clectric-diy/Spark-AE/README.md

Please use these available resources:
- [Canonical Documentation](https://clectric.diy/Spark-AE/)
- [Community Wiki](https://github.com/clectric-diy/Spark-AE/wiki)
- [clectric.diy Discussions](https://github.com/orgs/clectric-diy/discussions)
