clectric-diy/Spark-AE/KiCad/Spark-AE-Arcs/README.md

Arcs are expansion submodules that connect to the primary Spark module via SPI or I2C.
