clectric-diy/Spark-AE/docs/images/Spark-AE-1st-Sketch.png

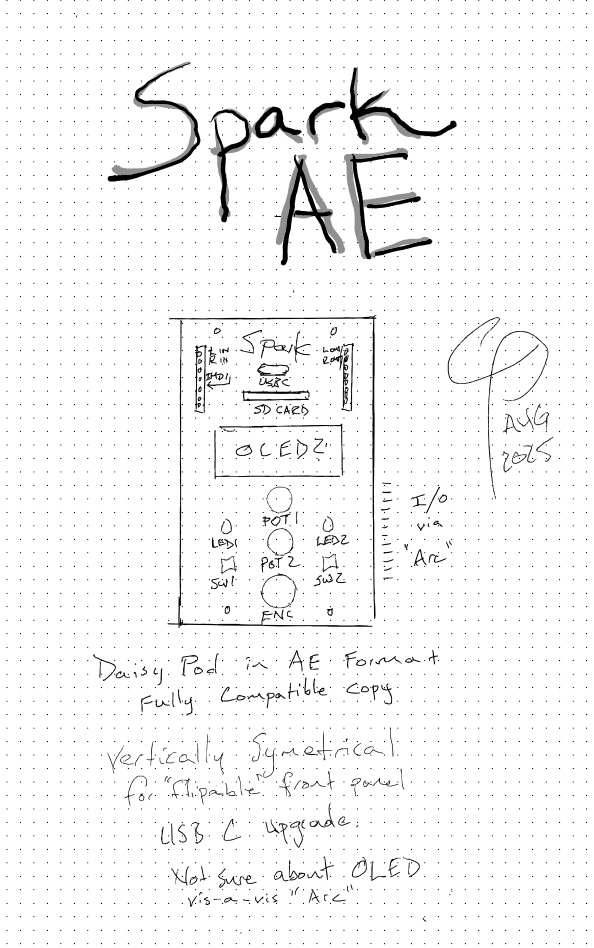
docs/images/Spark-AE-1st-Sketch.png
