clectric-diy/Spark-AE/docs/images/Spark-AE-PCB_Mk_0.0-DEV-Bottom.png

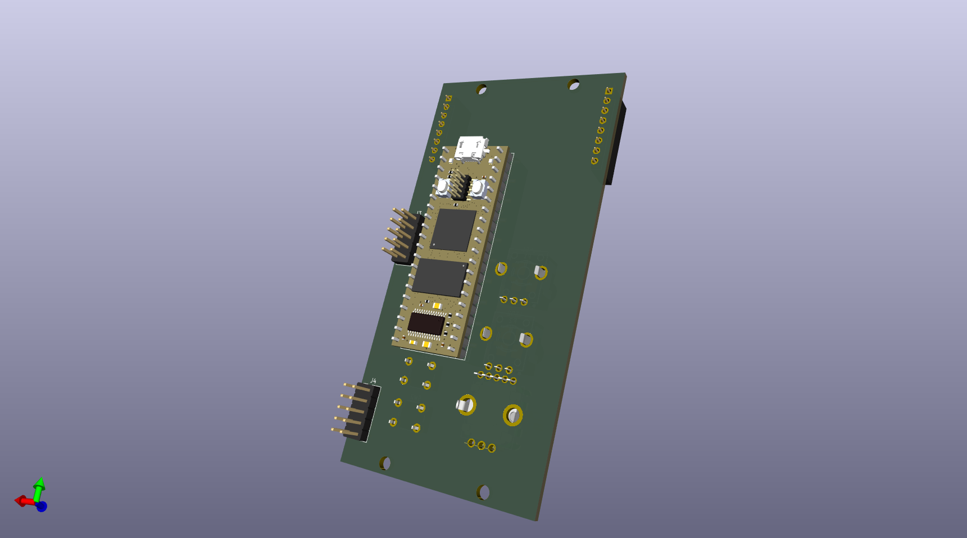
docs/images/Spark-AE-PCB_Mk_0.0-DEV-Bottom.png
