clectric-diy/Spark-AE/KiCad/Spark-AE-Panels/Spark-AE-Panel-Original/Lightburn/Spark-AE-Panel-Original-Edge_Cuts.dxf

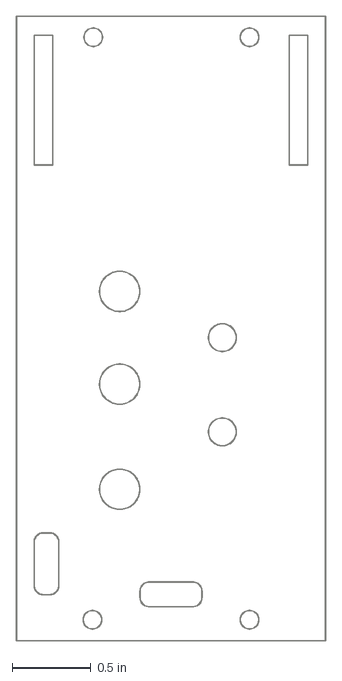
[picture p4: CAD file, 2026-04-26]
KiCad/Spark-AE-Panels/Spark-AE-Panel-Original/Lightburn/Spark-AE-Panel-Original-Edge_Cuts.dxf
1.97 x 3.98 in
