clectric-diy/Spark-AE/(list of files, cad)

Other CAD files:
KiCad/Spark-AE-Panels/Spark-AE-Panel-Original/Lightburn/Spark-AE-Panel-Original-F_Silkscreen.dxf
