clectric-diy/Spark-AE/docs/schematics/Spark-AE-Schematic-Mk0.1.pdf

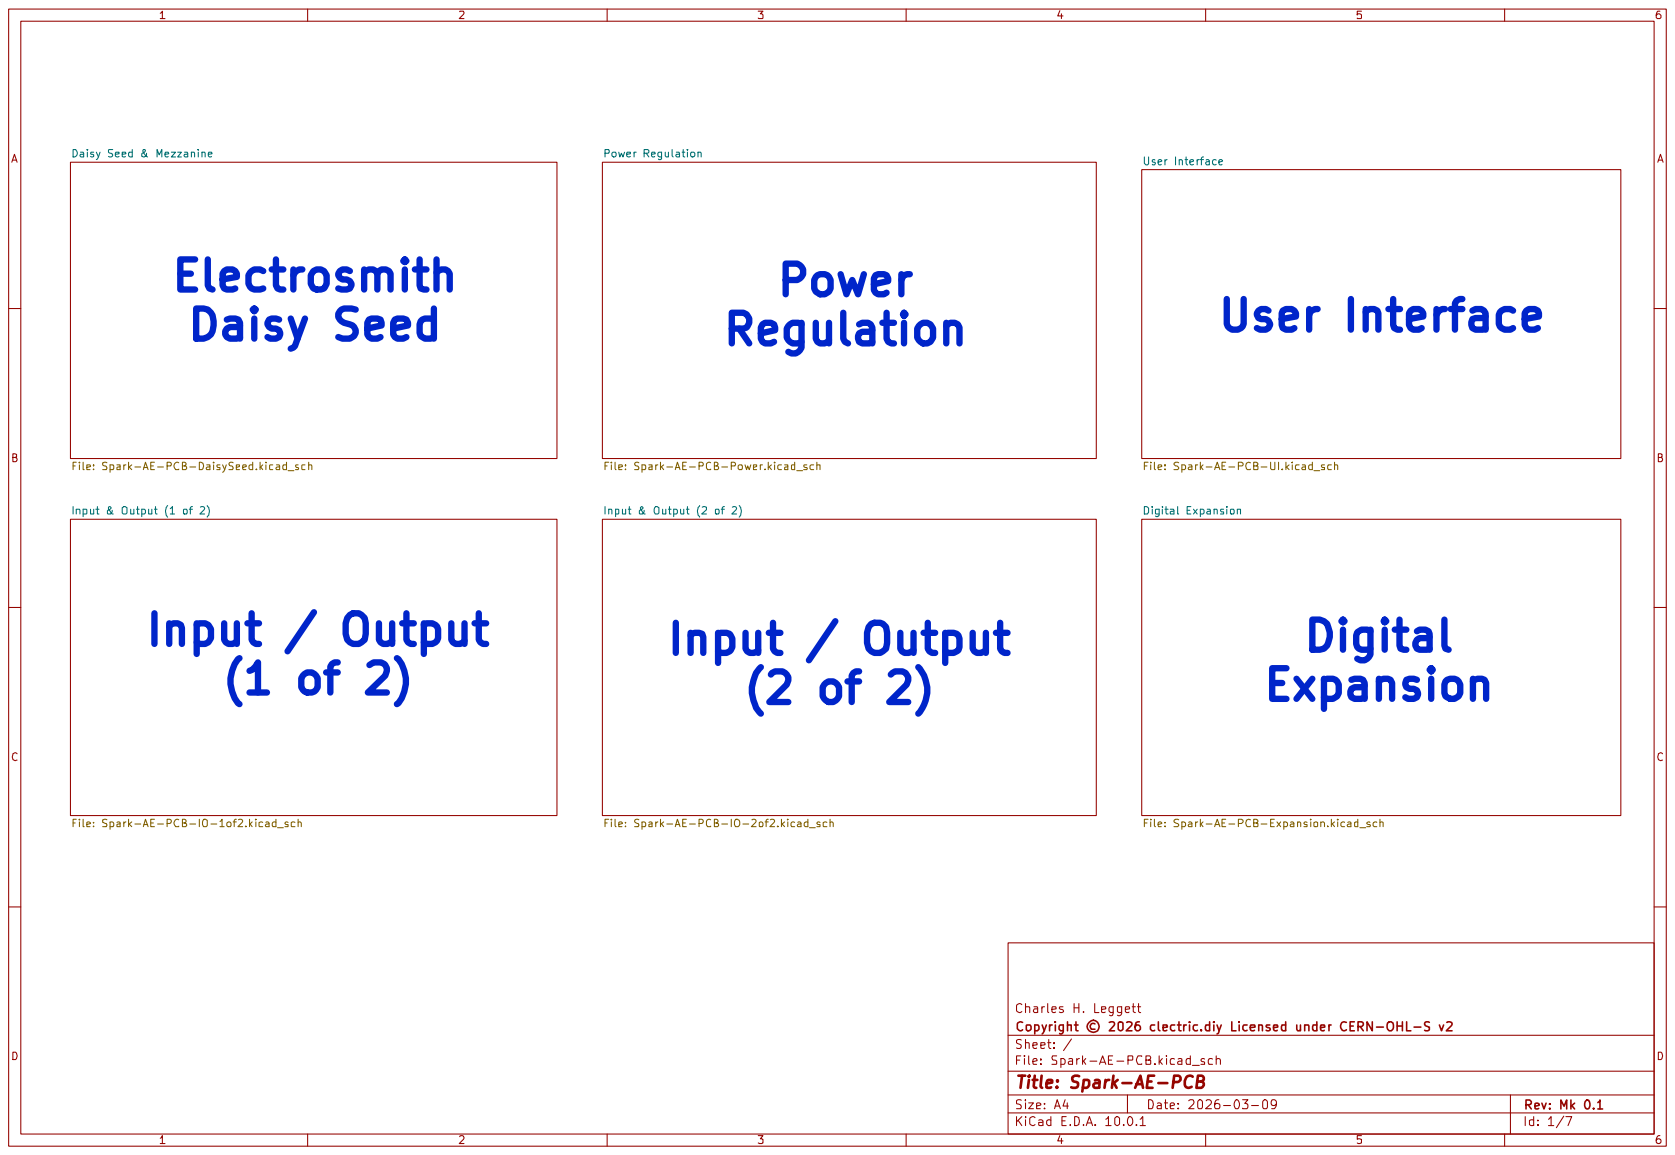
[picture p5: page 1]

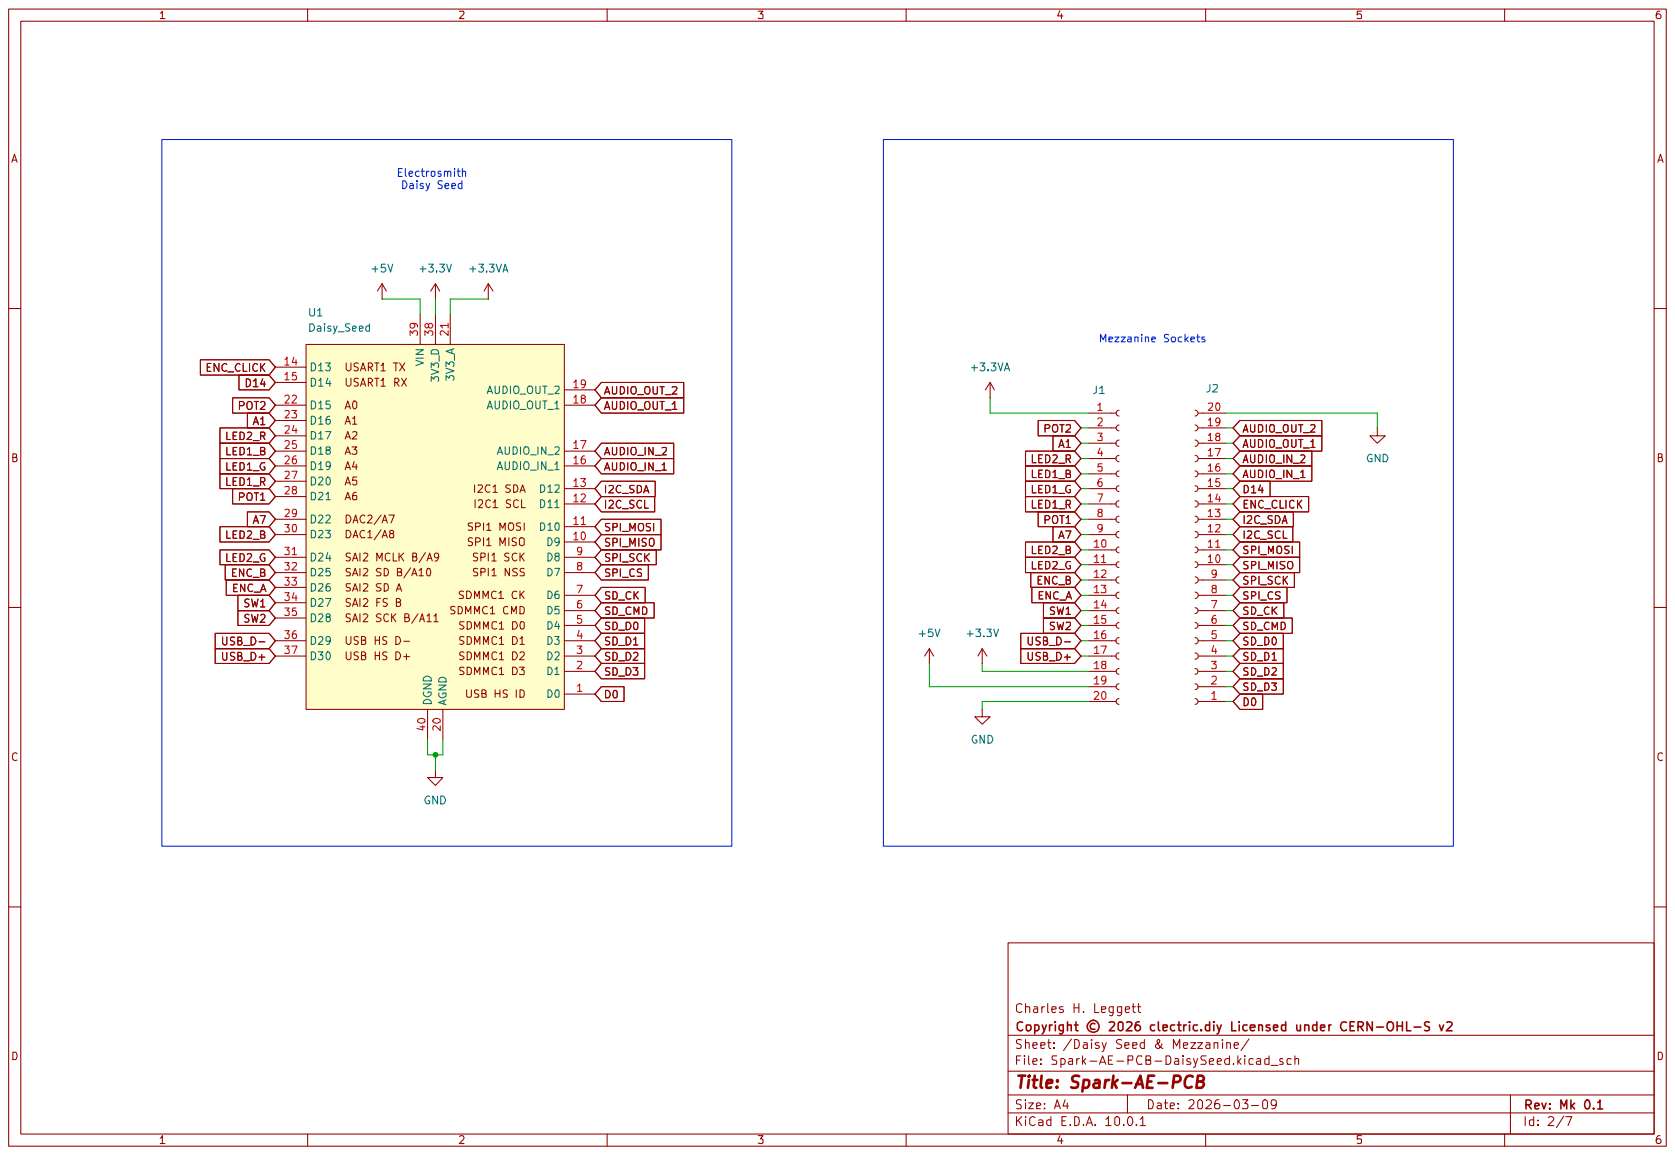
[picture p6: page 2]

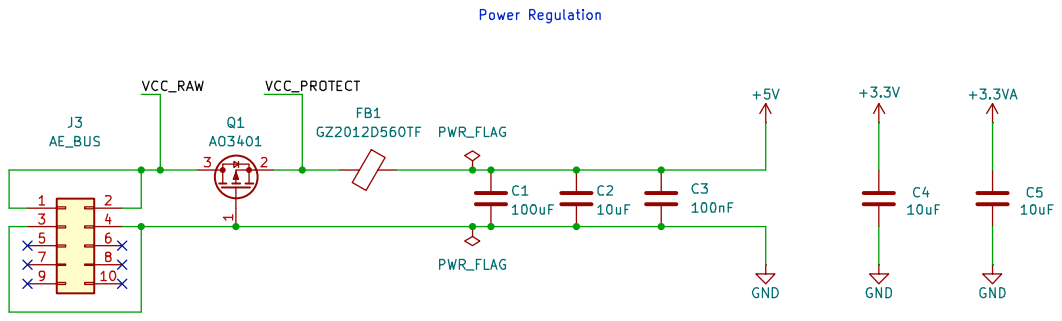
[picture p7: page 3]

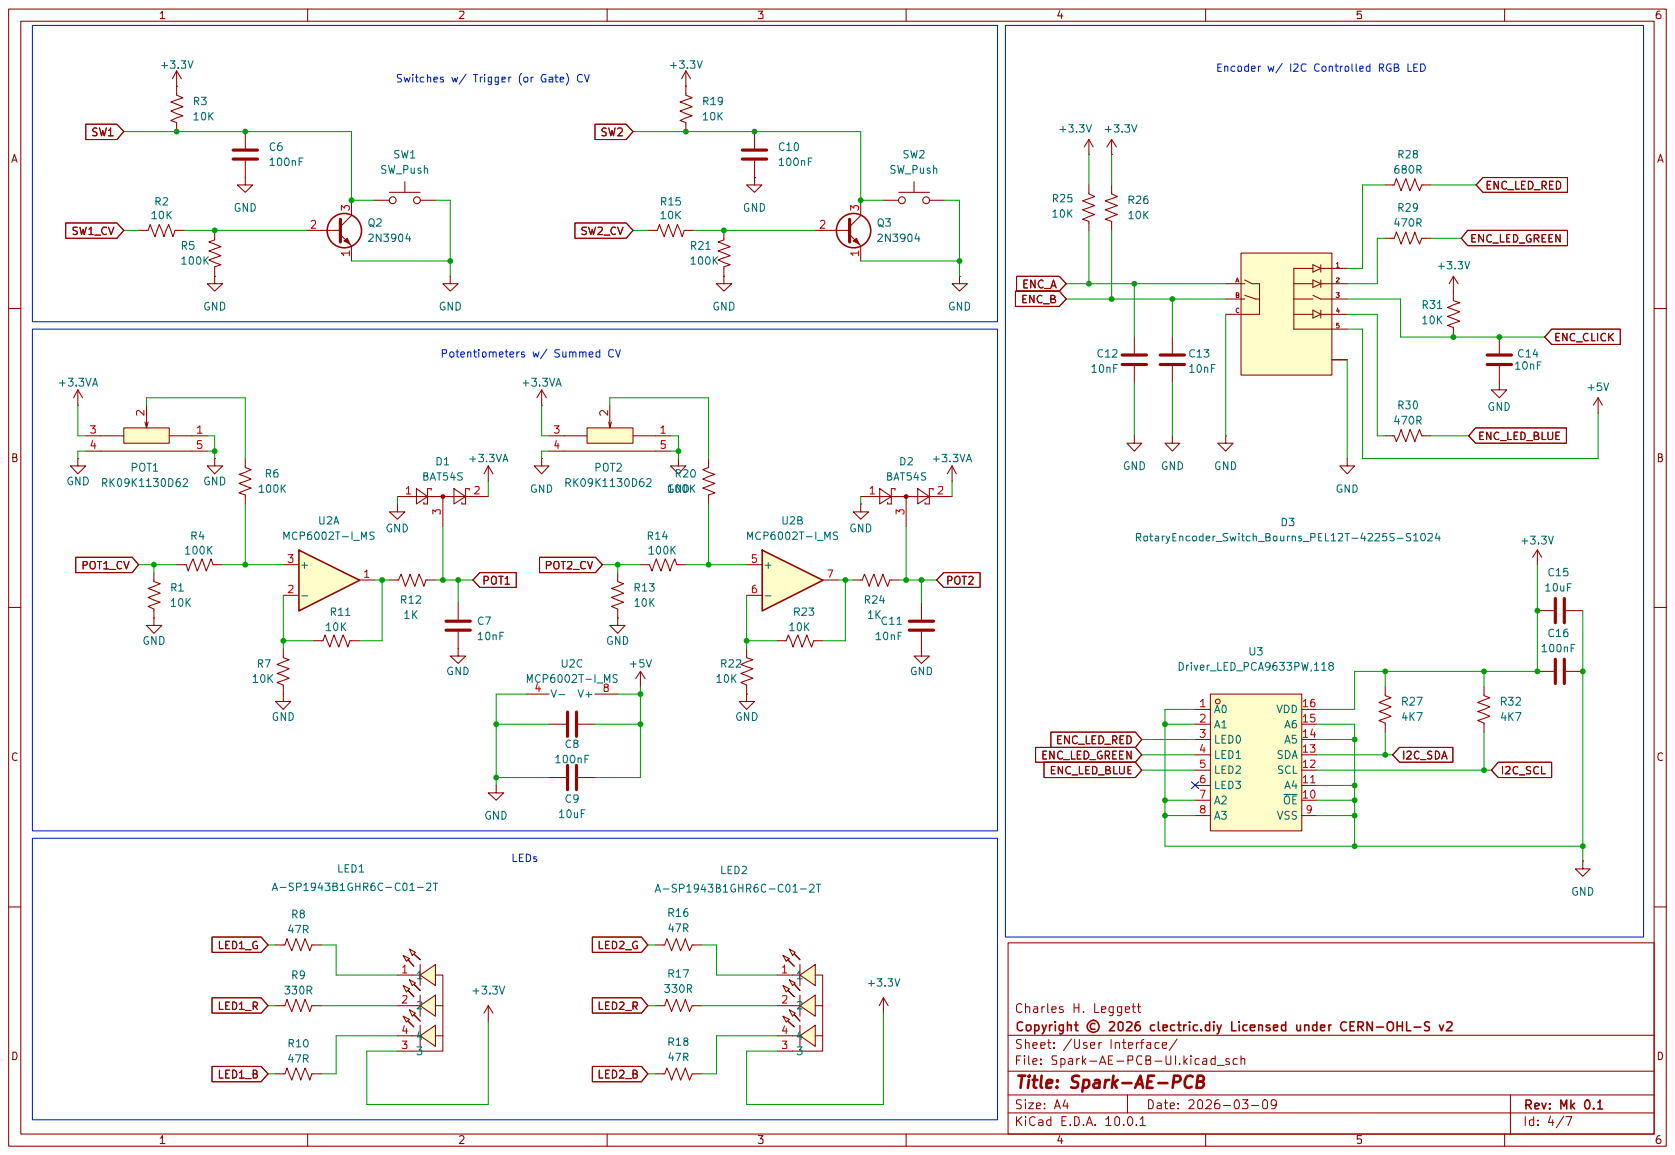
[picture p8: page 4]

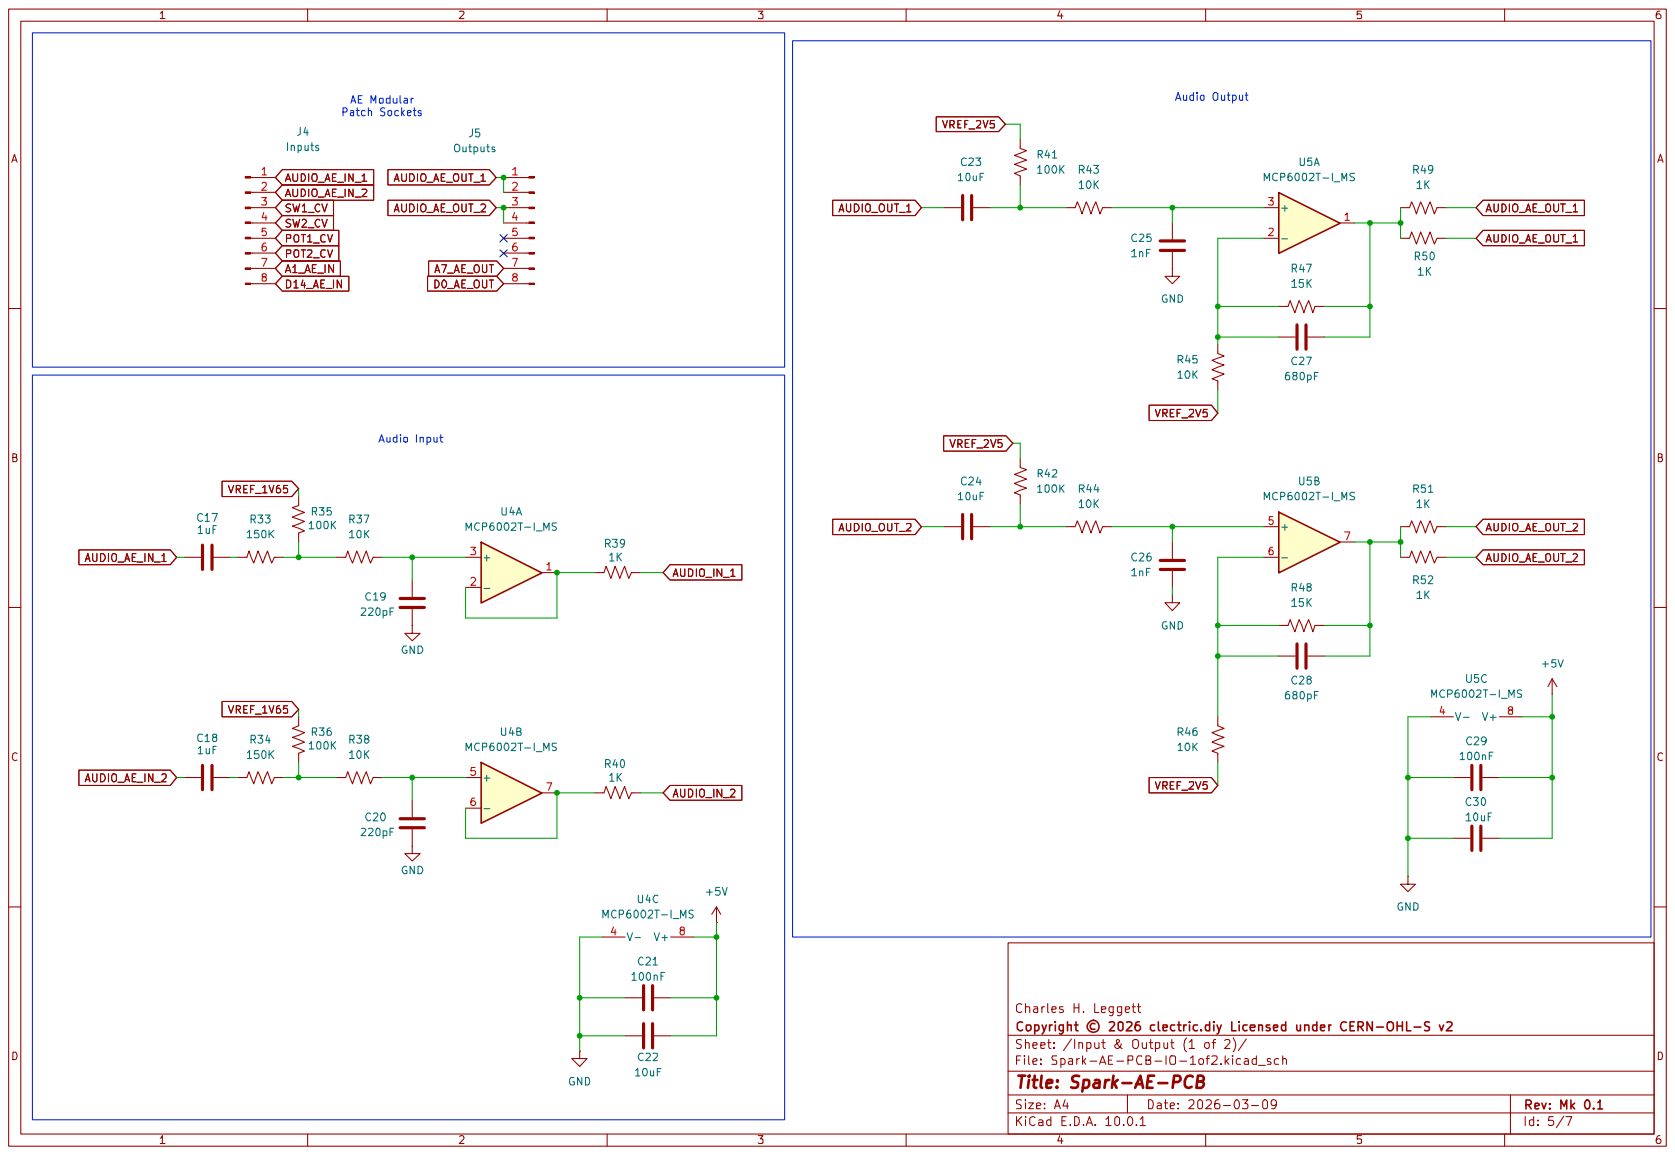
[picture p9: page 5]

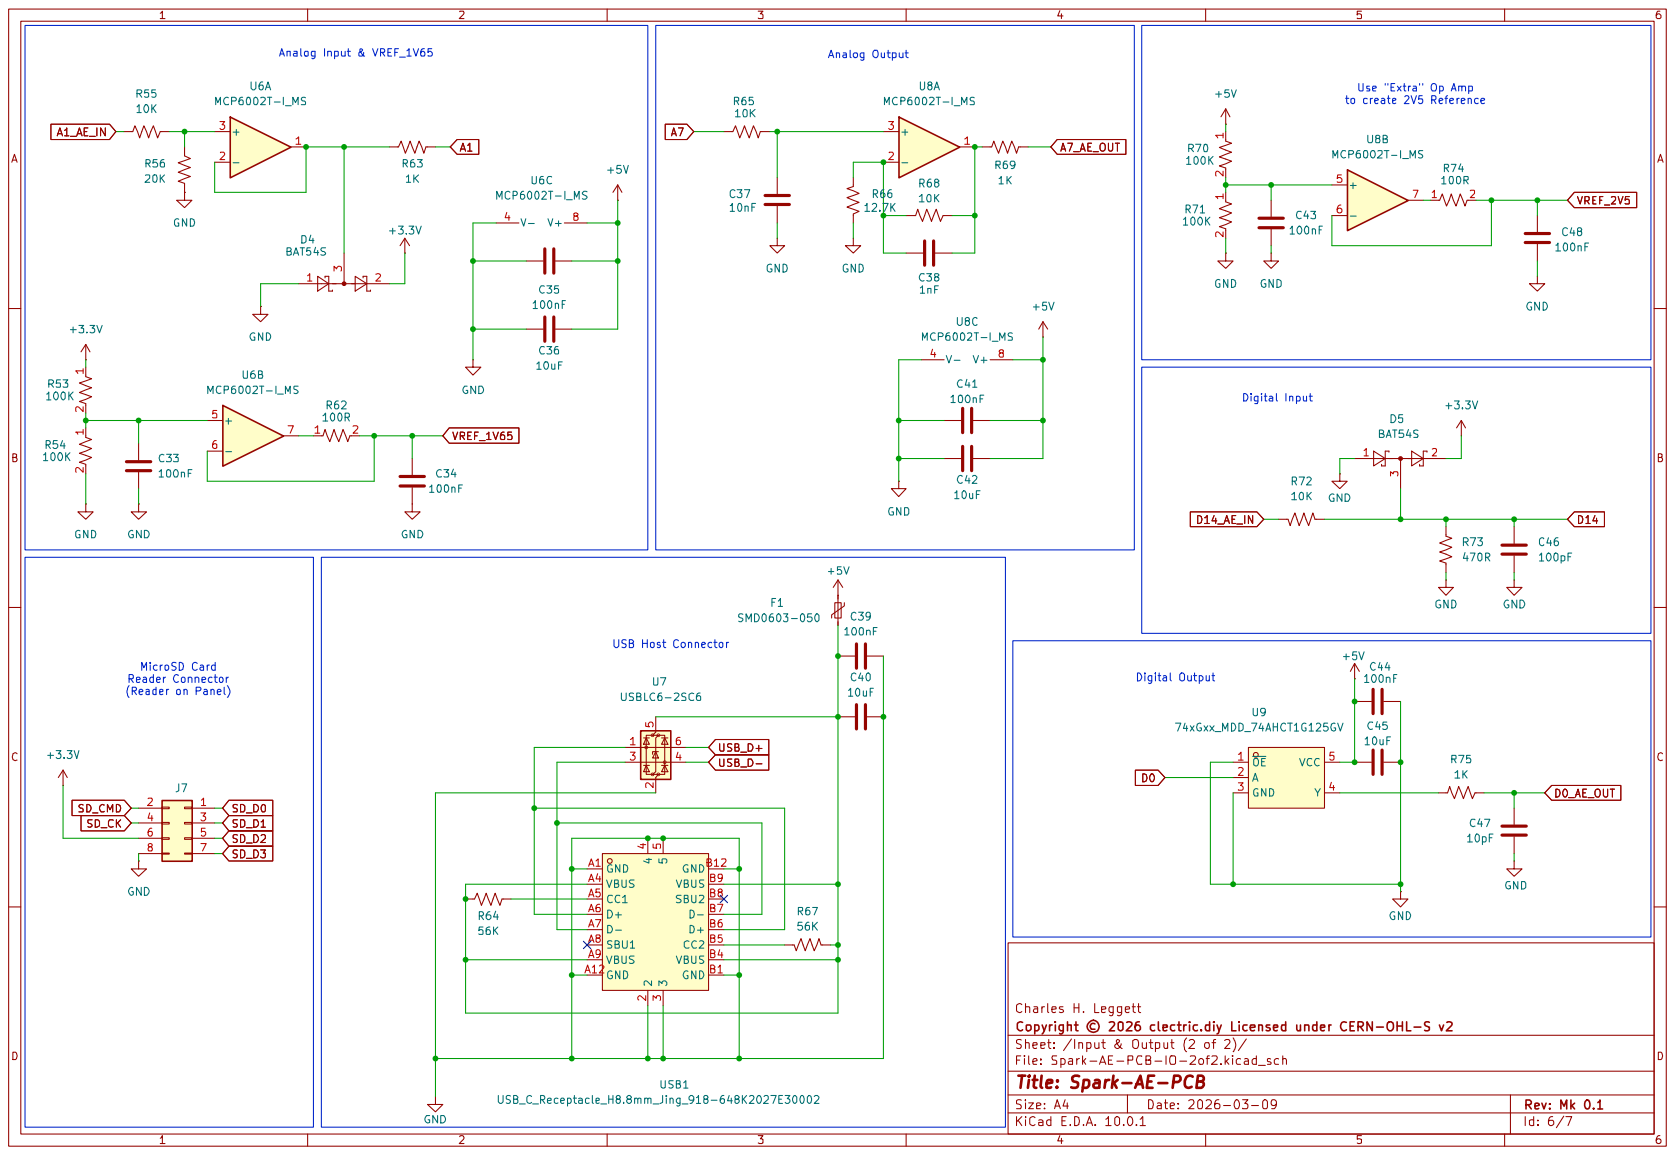
[picture p10: page 6]

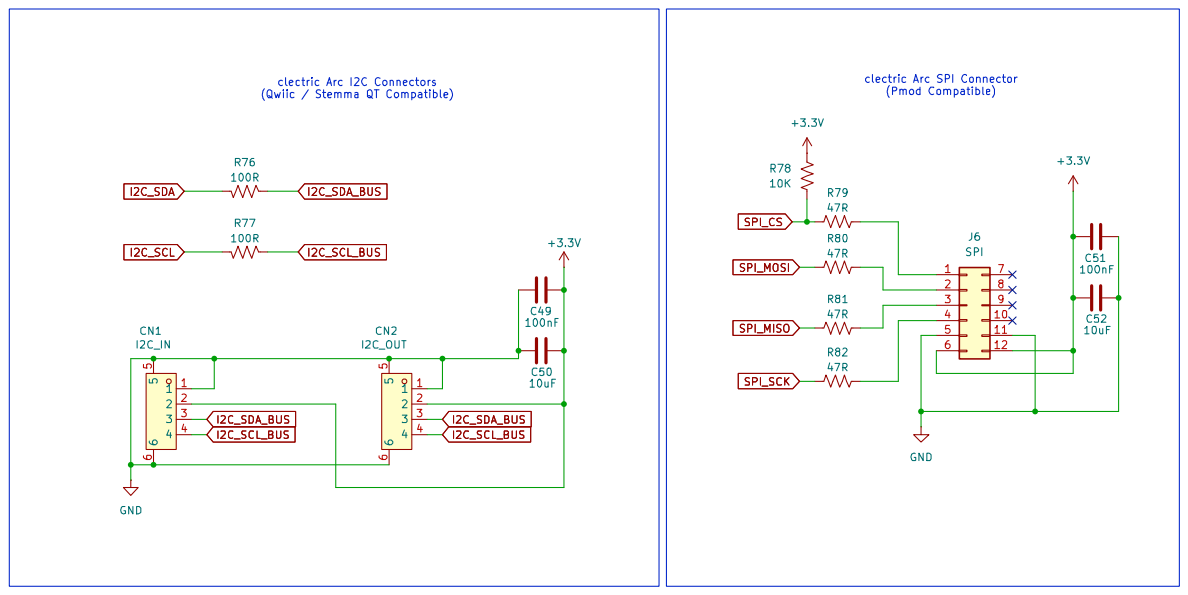
[picture p11: page 7]
