clectric-diy/Spark-AE/KiCad/Spark-AE-PCB/Spark-AE-PCB.kicad_pcb

## KiCad design KiCad/Spark-AE-PCB/Spark-AE-PCB.kicad_pcb (2026-04-16)

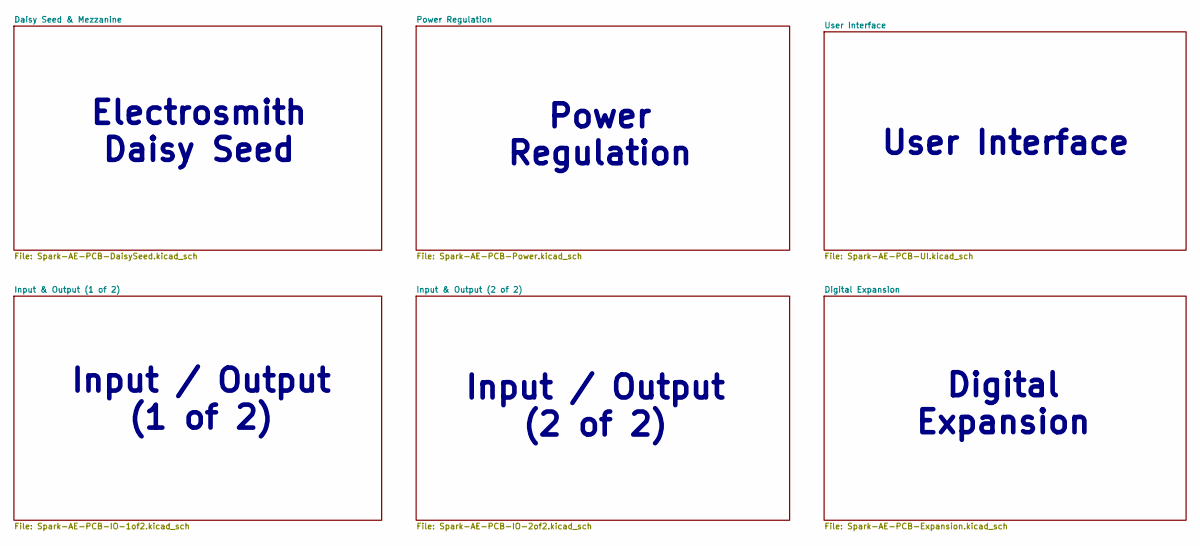
[picture p12: schematic Spark-AE-PCB.kicad_sch]

Notes on the sheet:
Input / Output (2 of 2)
Digital Expansion
User Interface
Input / Output (1 of 2)
Power Regulation
Electrosmith Daisy Seed

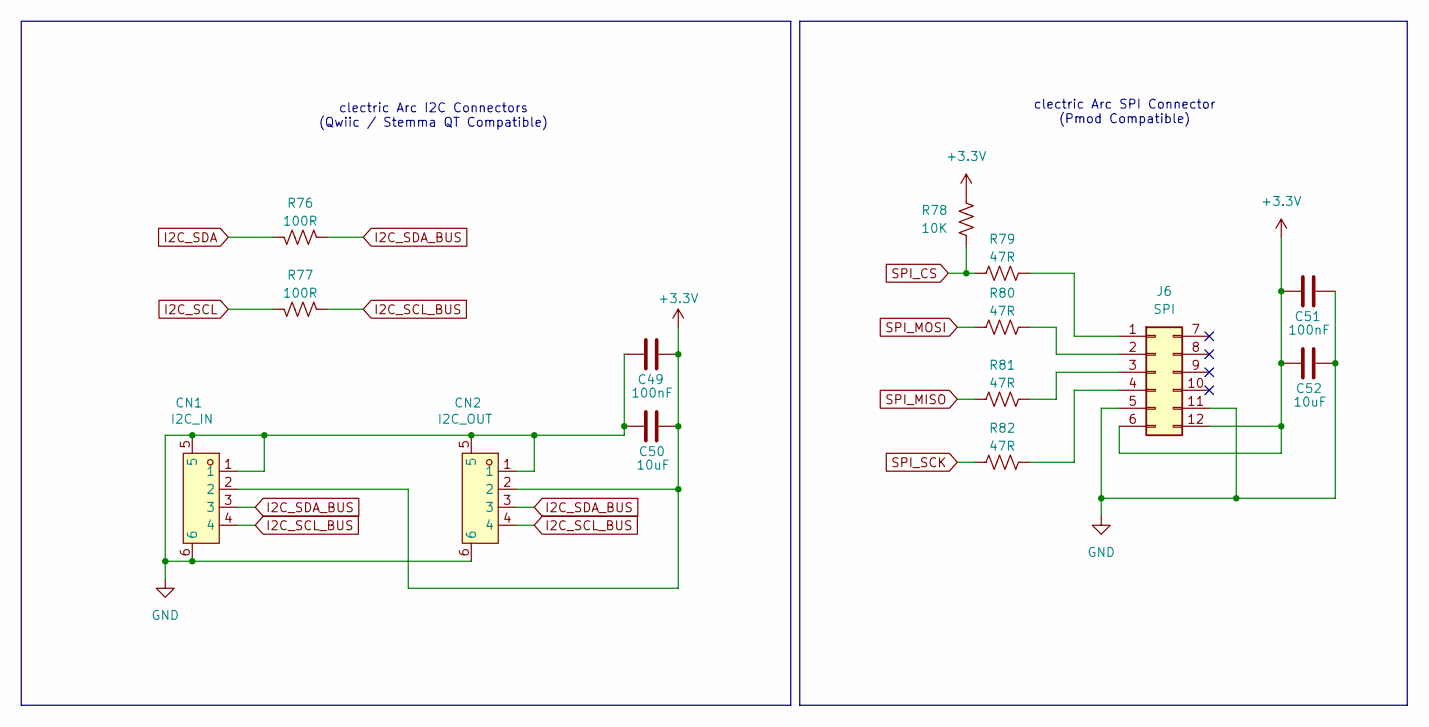
[picture p13: schematic Spark-AE-PCB-Expansion.kicad_sch, Spark-AE-PCB]

Parts:
C49, C51: 100nF; C_0603_1608Metric
C50, C52: 10uF; C_0603_1608Metric
CN1: I2C_IN; Connector_JST_BM04B-SRSS-TBT-LF-SN; LCSC Part C495539
CN2: I2C_OUT; Connector_JST_BM04B-SRSS-TBT-LF-SN; LCSC Part C495539
J6: SPI; PinHeader_2x06_P2.54mm_Vertical
R76, R77: 100R; R_0603_1608Metric
R78: 10K; R_0603_1608Metric
R79, R80, R81, R82: 47R; R_0603_1608Metric

Connections:
+3.3V: C49.2, C50.2, C51.1, C52.1, CN1.2, CN2.2, J6.6, J6.12, R78.1; also elsewhere on the board
GND: C49.1, C50.1, C51.2, C52.2, CN1.1, CN1.5, CN1.6, CN2.1, CN2.5, CN2.6, J6.5, J6.11; also elsewhere on the board
I2C_SCL: R77.2; also elsewhere on the board
I2C_SCL_BUS: CN1.4, CN2.4, R77.1
I2C_SDA: R76.2; also elsewhere on the board
I2C_SDA_BUS: CN1.3, CN2.3, R76.1
unnamed: J6.1, R79.2
unnamed: J6.2, R80.2
unnamed: J6.3, R81.2
unnamed: J6.4, R82.2
SPI_CS: R78.2, R79.1; also elsewhere on the board
SPI_MISO: R81.1; also elsewhere on the board
SPI_MOSI: R80.1; also elsewhere on the board
SPI_SCK: R82.1; also elsewhere on the board

Notes on the sheet:
clectric Arc SPI Connector (Pmod Compatible)
clectric Arc I2C Connectors (Qwiic / Stemma QT Compatible)

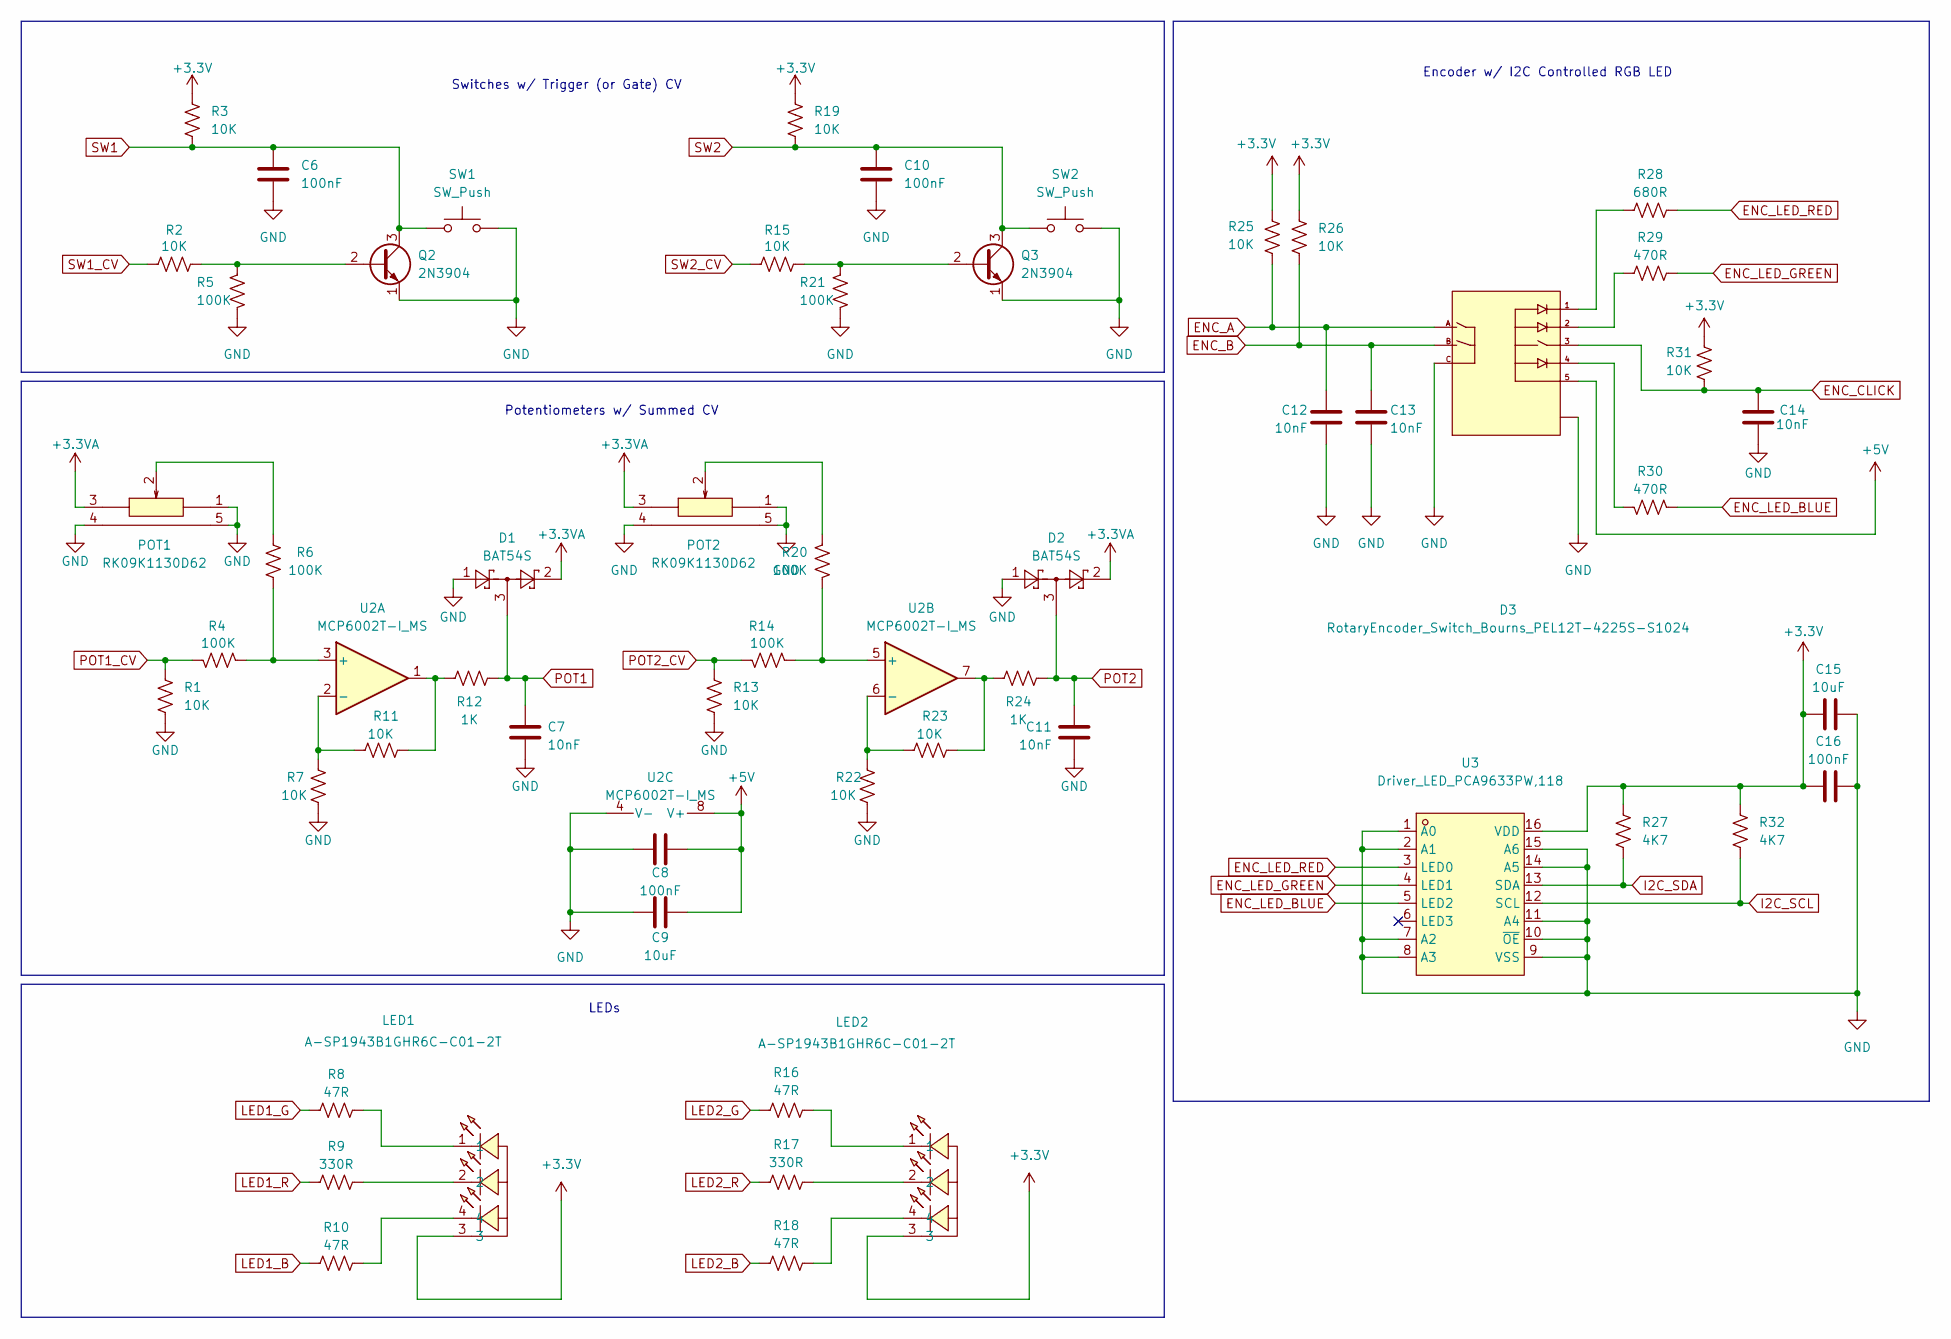
[picture p14: schematic Spark-AE-PCB-UI.kicad_sch, Spark-AE-PCB]

Parts:
C6, C8, C10, C16: 100nF; C_0603_1608Metric
C7, C11, C12, C13, C14: 10nF; C_0603_1608Metric
C9, C15: 10uF; C_0603_1608Metric
D1, D2: BAT54S; SOT-23
D3: RotaryEncoder_Switch_Bourns_PEL12T-4225S-S1024; PARTREV N/A
LED1, LED2: A-SP1943B1GHR6C-C01-2T; LED_ARGB_Amicc_A-SP1943B1GHR6C-C01-2T; LCSC Part C19171342
POT1, POT2: RK09K1130D62; Potentiometer_THT_Alps_RK09K1130D62; LCSC Part C470294
Q2, Q3: 2N3904; TO-92_Inline
R1, R2, R3, R7, R11, R13, R15, R19, R22, R23, R25, R26, R31: 10K; R_0603_1608Metric
R4, R5, R6, R14, R20, R21: 100K; R_0603_1608Metric
R8, R10, R16, R18: 47R; R_0603_1608Metric
R9, R17: 330R; R_0603_1608Metric
R12, R24: 1K; R_0603_1608Metric
R27, R32: 4K7; R_0603_1608Metric
R28: 680R; R_0603_1608Metric
R29, R30: 470R; R_0603_1608Metric
SW1, SW2: SW_Push; SW_PUSH_6mm
U2: MCP6002T-I_MS; Amplifier_Operational_Microchip_MCP6002T-I_MS
U3: Driver_LED_PCA9633PW,118; TSSOP-16_L5.0-W4.4-P0.64-LS6.4-BL; LCSC Part C2157802

Connections:
+3.3V: C15.1, C16.1, LED1.3, LED2.3, R3.1, R19.1, R25.1, R26.1, R27.1, R31.1, R32.1, U3.16 (VDD); also elsewhere on the board
+3.3VA: D1.2 (K), D2.2 (K), POT1.3, POT2.3; also elsewhere on the board
+5V: C8.1, C9.2, D3.5, U2.8 (V+); also elsewhere on the board
ENC_A: C12.1, D3.A, R25.2; also elsewhere on the board
ENC_B: C13.1, D3.B, R26.2; also elsewhere on the board
ENC_CLICK: C14.2, D3.3, R31.2; also elsewhere on the board
ENC_LED_BLUE: R30.1, U3.5 (LED2)
ENC_LED_GREEN: R29.2, U3.4 (LED1)
ENC_LED_RED: R28.2, U3.3 (LED0)
GND: C6.2, C7.2, C8.2, C9.1, C10.2, C11.2, C12.2, C13.2, C14.1, C15.2, C16.2, D1.1 (A), D2.1 (A), D3.C, D3.S1 (SHIELD), D3.S2 (SHIELD__1), POT1.1, POT1.4 (EH), POT1.5 (EH), POT2.1, POT2.4 (EH), POT2.5 (EH), Q2.1 (E), Q3.1 (E), R1.2, R5.2, R7.2, R13.2, R21.2, R22.2, SW1.2, SW2.2, U2.4 (V-), U3.1 (A0), U3.2 (A1), U3.7 (A2), U3.8 (A3), U3.9 (VSS), U3.10 (~OE), U3.11 (A4), U3.14 (A5), U3.15 (A6); also elsewhere on the board
I2C_SCL: R32.2, U3.12 (SCL); also elsewhere on the board
I2C_SDA: R27.2, U3.13 (SDA); also elsewhere on the board
LED1_B: R10.1; also elsewhere on the board
LED1_G: R8.1; also elsewhere on the board
LED1_R: R9.1; also elsewhere on the board
LED2_B: R18.1; also elsewhere on the board
LED2_G: R16.1; also elsewhere on the board
LED2_R: R17.1; also elsewhere on the board
unnamed: D3.1, R28.1
unnamed: D3.2, R29.1
unnamed: D3.4, R30.2
unnamed: LED1.1, R8.2
unnamed: LED1.2, R9.2
unnamed: LED1.4, R10.2
unnamed: LED2.1, R16.2
unnamed: LED2.2, R17.2
unnamed: LED2.4, R18.2
unnamed: POT1.2, R6.1
unnamed: POT2.2, R20.1
unnamed: Q2.2 (B), R2.2, R5.1
unnamed: Q3.2 (B), R15.2, R21.1
unnamed: R11.2, R12.1, U2.1
unnamed: R23.2, R24.1, U2.7
unnamed: R4.1, R6.2, U2.3 (+)
unnamed: R7.1, R11.1, U2.2 (-)
unnamed: R14.1, R20.2, U2.5 (+)
unnamed: R22.1, R23.1, U2.6 (-)
POT1: C7.1, D1.3 (COM), R12.2; also elsewhere on the board
POT1_CV: R1.1, R4.2; also elsewhere on the board
POT2: C11.1, D2.3 (COM), R24.2; also elsewhere on the board
POT2_CV: R13.1, R14.2; also elsewhere on the board
SW1: C6.1, Q2.3 (C), R3.2, SW1.1; also elsewhere on the board
SW1_CV: R2.1; also elsewhere on the board
SW2: C10.1, Q3.3 (C), R19.2, SW2.1; also elsewhere on the board
SW2_CV: R15.1; also elsewhere on the board

Notes on the sheet:
LEDs
Encoder w/ I2C Controlled RGB LED
Switches w/ Trigger (or Gate) CV
Potentiometers w/ Summed CV

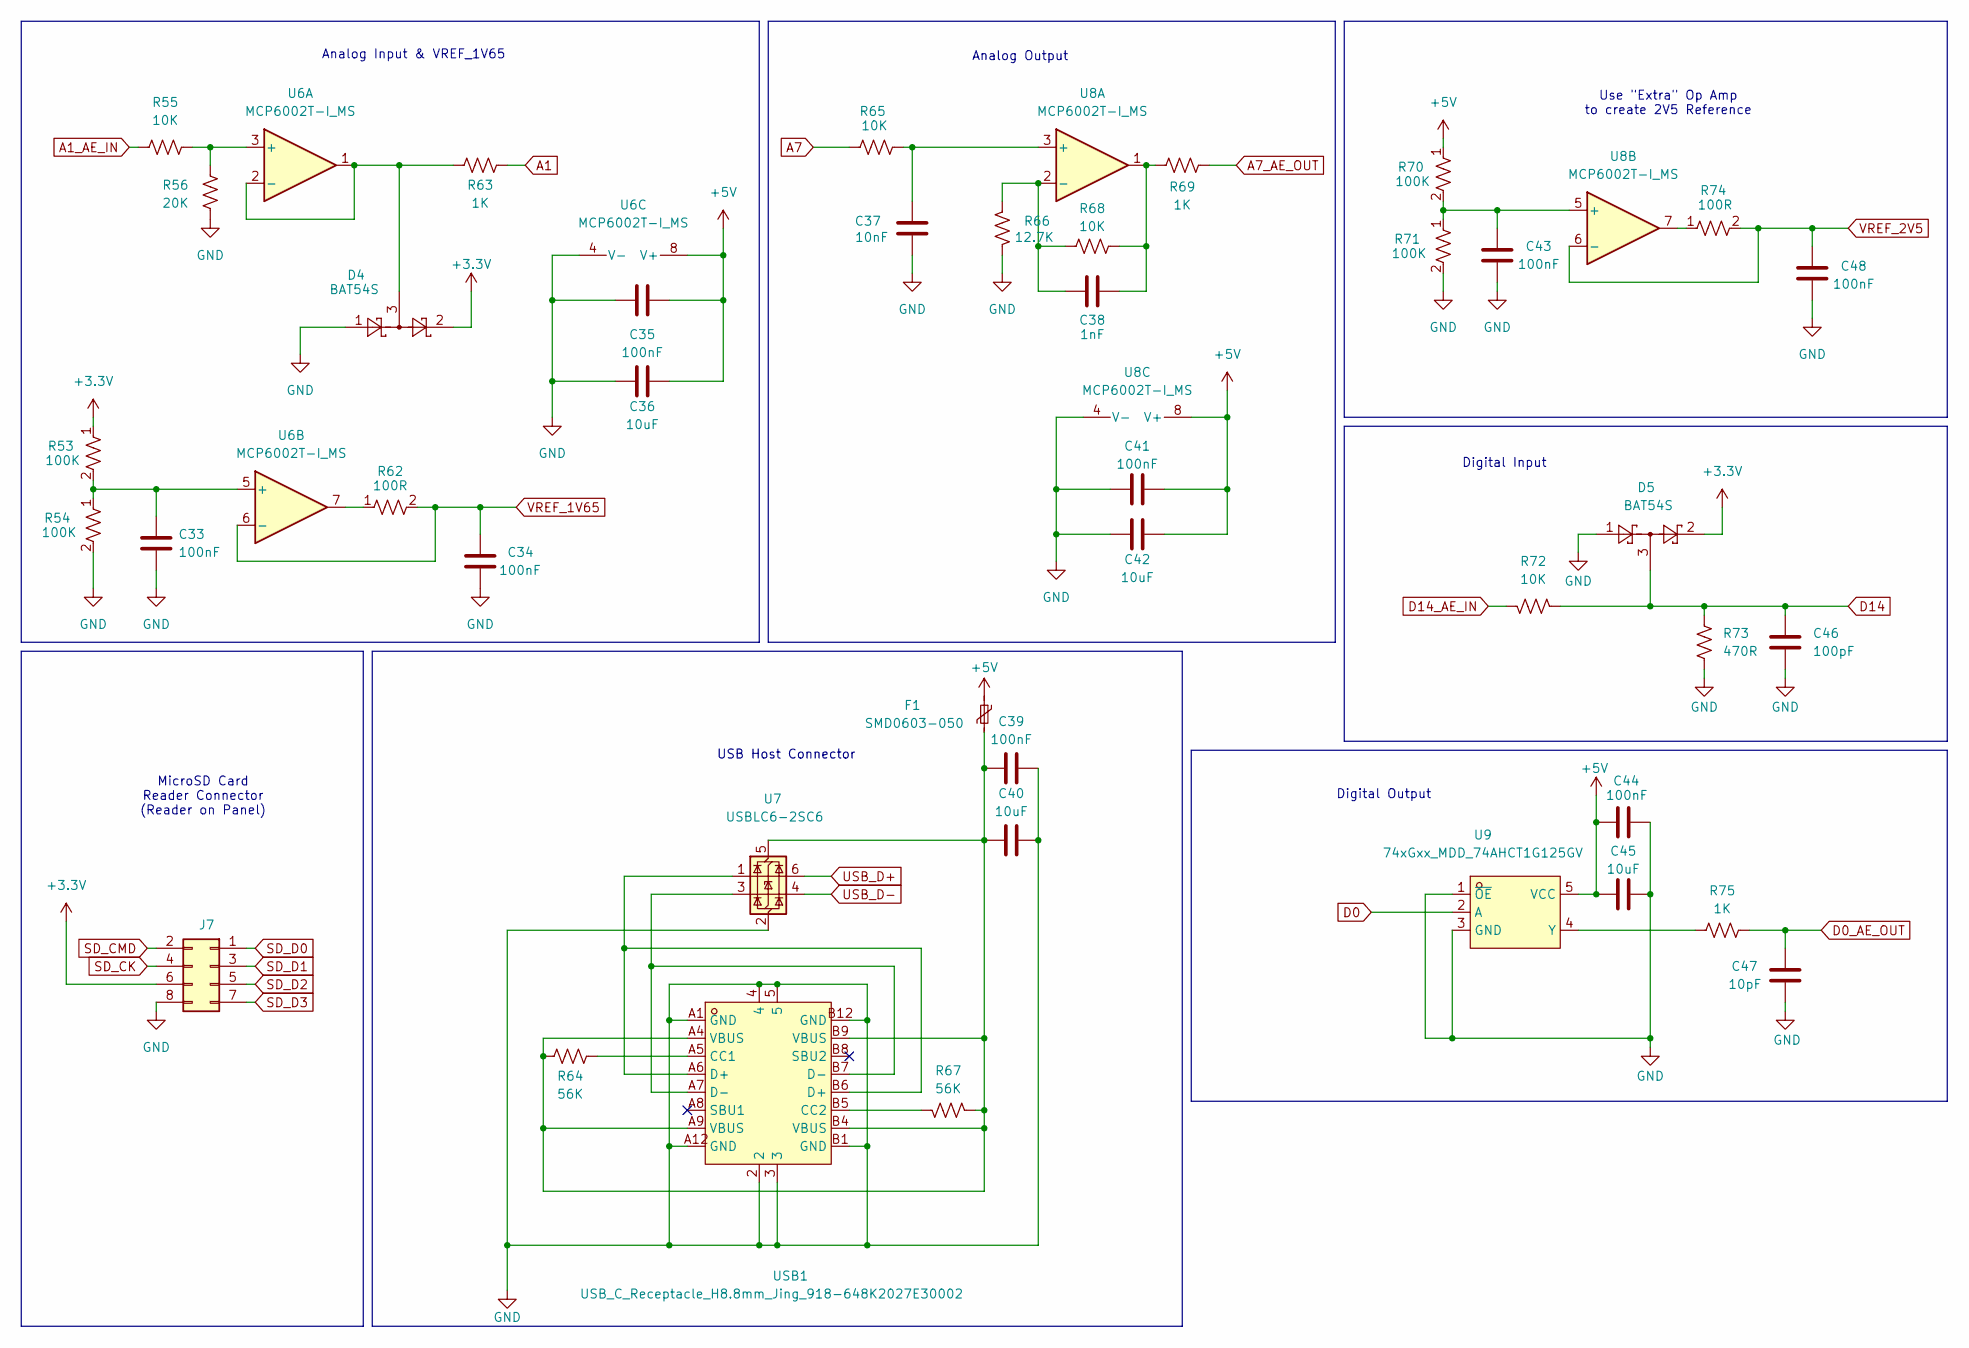
[picture p15: schematic Spark-AE-PCB-IO-2of2.kicad_sch, Spark-AE-PCB]

Parts:
C33, C34, C35, C39, C41, C43, C44, C48: 100nF; C_0603_1608Metric
C36, C40, C42, C45: 10uF; C_0603_1608Metric
C37: 10nF; C_0603_1608Metric
C38: 1nF; C_0603_1608Metric
C46: 100pF; C_0603_1608Metric
C47: 10pF; C_0603_1608Metric
D4, D5: BAT54S; SOT-23
F1: SMD0603-050; Fuse_0603_1608Metric
J7: SD_CONN; PinSocket_2x04_P2.54mm_Vertical
R53, R54, R70, R71: 100K; R_0603_1608Metric
R55, R65, R68, R72: 10K; R_0603_1608Metric
R56: 20K; R_0603_1608Metric
R62, R74: 100R; R_0603_1608Metric
R63, R69, R75: 1K; R_0603_1608Metric
R64, R67: 56K; R_0603_1608Metric
R66: 12.7K; R_0603_1608Metric
R73: 470R; R_0603_1608Metric
U6, U8: MCP6002T-I_MS; Amplifier_Operational_Microchip_MCP6002T-I_MS
U7: USBLC6-2SC6; SOT-23-6
U9: 74xGxx_MDD_74AHCT1G125GV; LCSC Part C52140417
USB1: USB_C_Receptacle_H8.8mm_Jing_918-648K2027E30002; LCSC Part C5139026

Connections:
+3.3V: D4.2 (K), D5.2 (K), J7.6, R53.1; also elsewhere on the board
+5V: C35.2, C36.2, C41.2, C42.2, C44.1, C45.2, F1.1, R70.1, U6.8 (V+), U8.8 (V+), U9.5 (VCC); also elsewhere on the board
A1: R63.2; also elsewhere on the board
A1_AE_IN: R55.1; also elsewhere on the board
A7: R65.1; also elsewhere on the board
A7_AE_OUT: R69.2; also elsewhere on the board
D0: U9.2 (A); also elsewhere on the board
D0_AE_OUT: C47.1, R75.1; also elsewhere on the board
D14: C46.1, D5.3 (COM), R72.2, R73.1; also elsewhere on the board
D14_AE_IN: R72.1; also elsewhere on the board
GND: C33.2, C34.2, C35.1, C36.1, C37.2, C39.2, C40.2, C41.1, C42.1, C43.2, C44.2, C45.1, C46.2, C47.2, C48.1, D4.1 (A), D5.1 (A), J7.8, R54.2, R56.2, R66.1, R71.2, R73.2, U6.4 (V-), U7.2 (GND), U8.4 (V-), U9.1 (~OE), U9.3 (GND), USB1.2, USB1.3, USB1.4, USB1.5, USB1.A1 (GND), USB1.A12 (GND), USB1.B1 (GND), USB1.B12 (GND); also elsewhere on the board
unnamed: C38.1, R68.2, R69.1, U8.1
unnamed: D4.3 (COM), R63.1, U6.1, U6.2 (-)
unnamed: R62.1, U6.7
unnamed: R74.1, U8.7
unnamed: R55.2, R56.1, U6.3 (+)
unnamed: C33.1, R53.2, R54.1, U6.5 (+)
unnamed: U7.1 (I/O1), USB1.A6 (D+), USB1.B6 (D+)
unnamed: U7.3 (I/O2), USB1.A7 (D-), USB1.B7 (D-)
unnamed: C39.1, C40.1, F1.2, R64.1, R67.1, U7.5 (VBUS), USB1.A4 (VBUS), USB1.A9 (VBUS), USB1.B4 (VBUS), USB1.B9 (VBUS)
unnamed: C37.1, R65.2, U8.3 (+)
unnamed: C38.2, R66.2, R68.1, U8.2 (-)
unnamed: C43.1, R70.2, R71.1, U8.5 (+)
unnamed: R75.2, U9.4 (Y)
unnamed: R64.2, USB1.A5 (CC1)
unnamed: R67.2, USB1.B5 (CC2)
SD_CK: J7.4; also elsewhere on the board
SD_CMD: J7.2; also elsewhere on the board
SD_D0: J7.1; also elsewhere on the board
SD_D1: J7.3; also elsewhere on the board
SD_D2: J7.5; also elsewhere on the board
SD_D3: J7.7; also elsewhere on the board
USB_D+: U7.6 (I/O1); also elsewhere on the board
USB_D-: U7.4 (I/O2); also elsewhere on the board
VREF_1V65: C34.1, R62.2, U6.6 (-); also elsewhere on the board
VREF_2V5: C48.2, R74.2, U8.6 (-); also elsewhere on the board

Notes on the sheet:
Analog Input & VREF_1V65
MicroSD Card Reader Connector (Reader on Panel)
Analog Output
Digital Input
USB Host Connector
Digital Output
Use "Extra" Op Amp to create 2V5 Reference

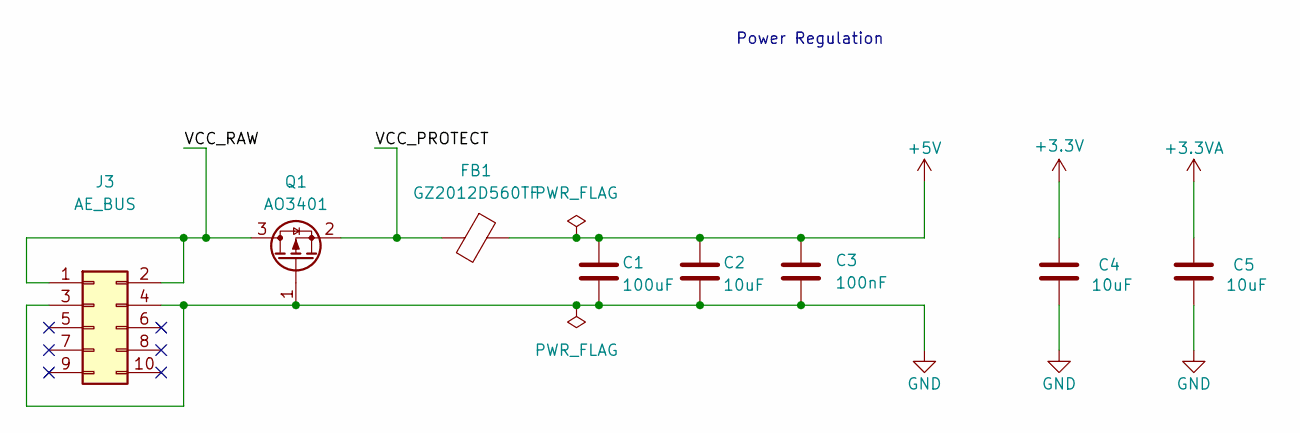
[picture p16: schematic Spark-AE-PCB-Power.kicad_sch, Spark-AE-PCB]

Parts:
C1: 100uF; C_0805_2012Metric
C2: 10uF; C_0805_2012Metric
C3: 100nF; C_0805_2012Metric
C4, C5: 10uF; C_0603_1608Metric
FB1: GZ2012D560TF; L_0805_2012Metric
J3: AE_BUS; PinHeader_2x05_P2.54mm_Vertical
Q1: AO3401; SOT-23

Connections:
+3.3V: C4.2; also elsewhere on the board
+3.3VA: C5.2; also elsewhere on the board
+5V: C1.1, C2.1, C3.1, FB1.1; also elsewhere on the board
/Power Regulation/VCC_PROTECT: FB1.2, Q1.2 (S)
/Power Regulation/VCC_RAW: J3.1, J3.2, Q1.3 (D)
GND: C1.2, C2.2, C3.2, C4.1, C5.1, J3.3, J3.4, Q1.1 (G); also elsewhere on the board

Notes on the sheet:
Power Regulation

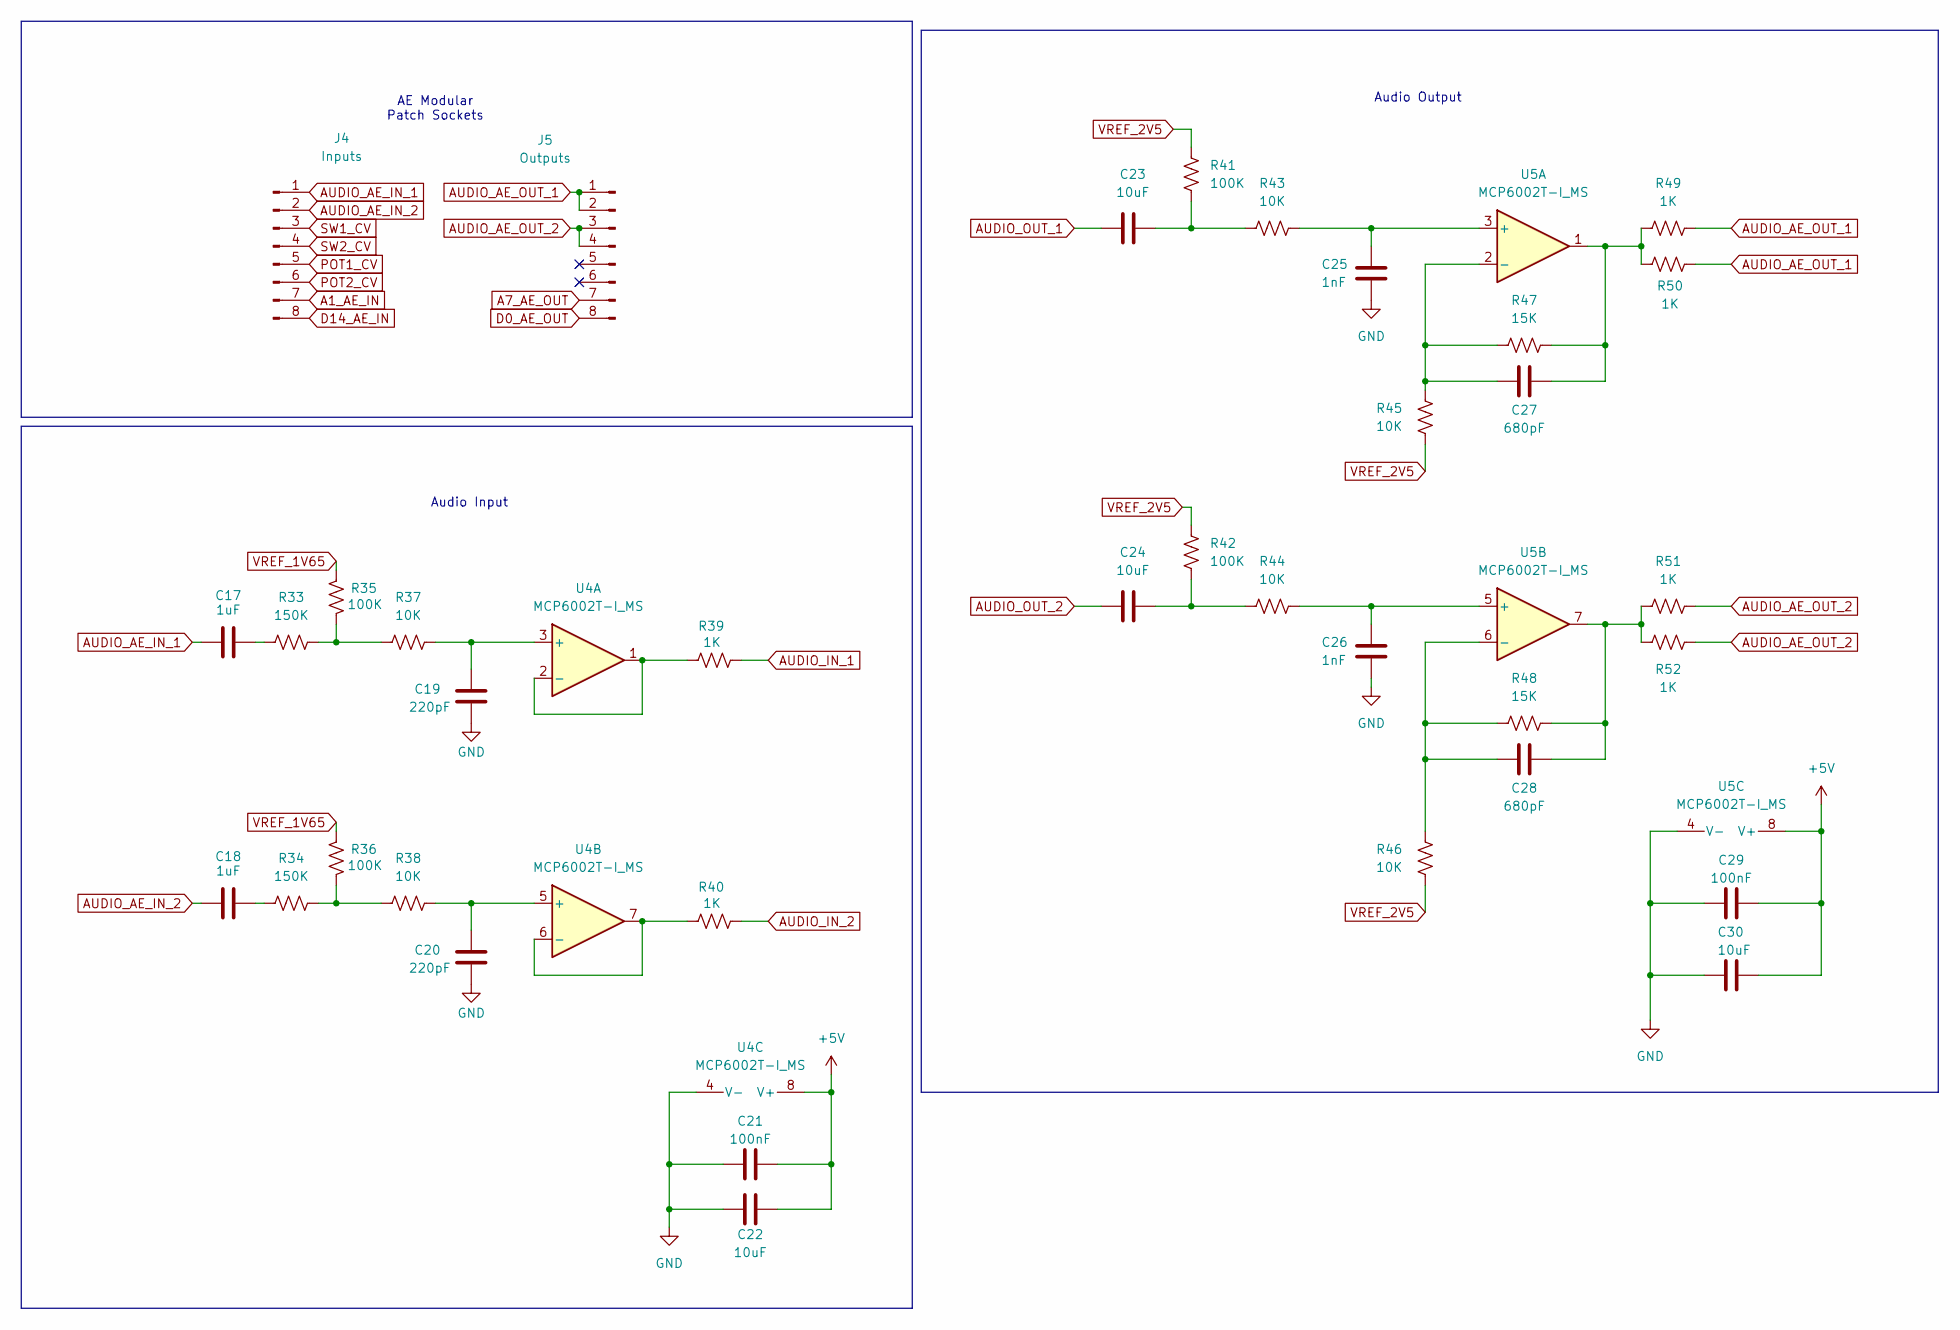
[picture p17: schematic Spark-AE-PCB-IO-1of2.kicad_sch, Spark-AE-PCB]

Parts:
C17, C18: 1uF; C_0603_1608Metric
C19, C20: 220pF; C_0603_1608Metric
C21, C29: 100nF; C_0603_1608Metric
C22, C23, C24, C30: 10uF; C_0603_1608Metric
C25, C26: 1nF; C_0603_1608Metric
C27, C28: 680pF; C_0603_1608Metric
J4: Inputs; Connector_PinSocket-1x08-P2.54mm-H8.5mm_Preci-Dip_801-87-00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
J5: Outputs; Connector_PinSocket-1x08-P2.54mm-H8.5mm_Preci-Dip_801-87-00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
R33, R34: 150K; R_0603_1608Metric
R35, R36, R41, R42: 100K; R_0603_1608Metric
R37, R38, R43, R44, R45, R46: 10K; R_0603_1608Metric
R39, R40, R49, R50, R51, R52: 1K; R_0603_1608Metric
R47, R48: 15K; R_0603_1608Metric
U4, U5: MCP6002T-I_MS; Amplifier_Operational_Microchip_MCP6002T-I_MS

Connections:
+5V: C21.2, C22.2, C29.2, C30.1, U4.8 (V+), U5.8 (V+); also elsewhere on the board
A1_AE_IN: J4.7; also elsewhere on the board
A7_AE_OUT: J5.7; also elsewhere on the board
AUDIO_AE_IN_1: C17.1, J4.1
AUDIO_AE_IN_2: C18.1, J4.2
AUDIO_AE_OUT_1: J5.1, J5.2, R49.2, R50.2
AUDIO_AE_OUT_2: J5.3, J5.4, R51.2, R52.2
AUDIO_IN_1: R39.1; also elsewhere on the board
AUDIO_IN_2: R40.1; also elsewhere on the board
AUDIO_OUT_1: C23.2; also elsewhere on the board
AUDIO_OUT_2: C24.2; also elsewhere on the board
D0_AE_OUT: J5.8; also elsewhere on the board
D14_AE_IN: J4.8; also elsewhere on the board
GND: C19.2, C20.2, C21.1, C22.1, C25.2, C26.2, C29.1, C30.2, U4.4 (V-), U5.4 (V-); also elsewhere on the board
unnamed: C17.2, R33.1
unnamed: C18.2, R34.1
unnamed: C23.1, R41.2, R43.1
unnamed: C24.1, R42.2, R44.1
unnamed: C27.1, R47.2, R49.1, R50.1, U5.1
unnamed: C28.1, R48.2, R51.1, R52.1, U5.7
unnamed: R33.2, R35.1, R37.1
unnamed: R34.2, R36.1, R38.1
unnamed: C19.1, R37.2, U4.3 (+)
unnamed: R39.2, U4.1, U4.2 (-)
unnamed: C20.1, R38.2, U4.5 (+)
unnamed: R40.2, U4.6 (-), U4.7
unnamed: C25.1, R43.2, U5.3 (+)
unnamed: C27.2, R45.2, R47.1, U5.2 (-)
unnamed: C26.1, R44.2, U5.5 (+)
unnamed: C28.2, R46.2, R48.1, U5.6 (-)
POT1_CV: J4.5; also elsewhere on the board
POT2_CV: J4.6; also elsewhere on the board
SW1_CV: J4.3; also elsewhere on the board
SW2_CV: J4.4; also elsewhere on the board
VREF_1V65: R35.2, R36.2; also elsewhere on the board
VREF_2V5: R41.1, R42.1, R45.1, R46.1; also elsewhere on the board

Notes on the sheet:
Audio Input
Audio Output
AE Modular Patch Sockets

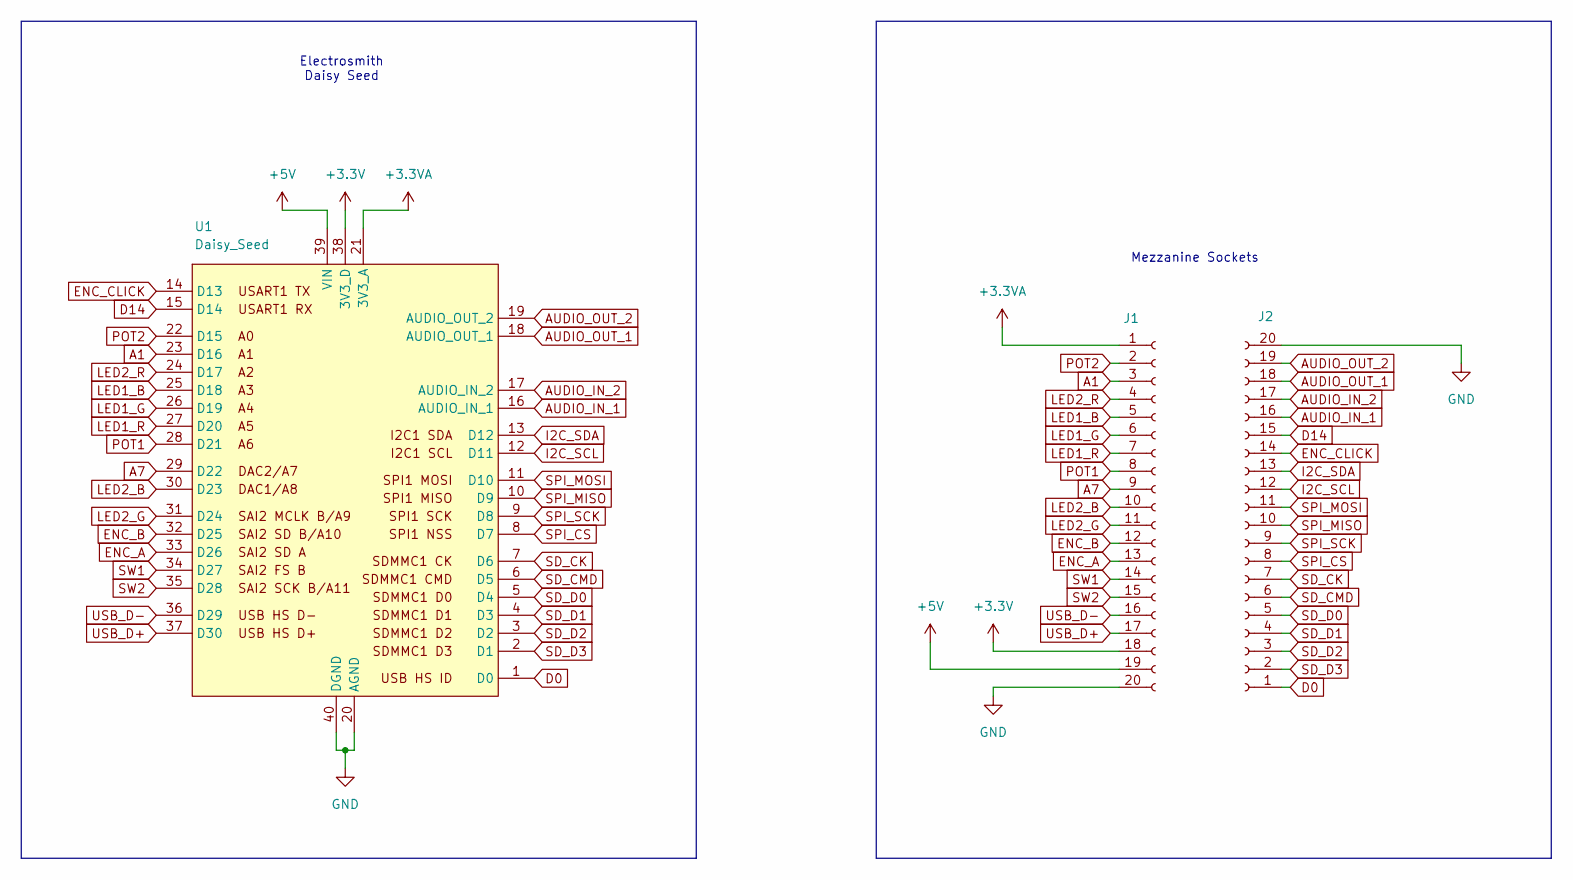
[picture p18: schematic Spark-AE-PCB-DaisySeed.kicad_sch, Spark-AE-PCB]

Parts:
J1, J2: Conn_01x20_Socket; Connector_PinSocket-1x20-P2.54mm-H1.27mm_Mill-Max_315-13-12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
U1: Daisy_Seed; MCU_Module_Electrosmith_DAISY_SEED

Connections:
+3.3V: J1.18, U1.38 (3V3_D); also elsewhere on the board
+3.3VA: J1.1, U1.21 (3V3_A); also elsewhere on the board
+5V: J1.19, U1.39 (VIN); also elsewhere on the board
A1: J1.3, U1.23 (D16); also elsewhere on the board
A7: J1.9, U1.29 (D22); also elsewhere on the board
AUDIO_IN_1: J2.16, U1.16 (AUDIO_IN_1); also elsewhere on the board
AUDIO_IN_2: J2.17, U1.17 (AUDIO_IN_2); also elsewhere on the board
AUDIO_OUT_1: J2.18, U1.18 (AUDIO_OUT_1); also elsewhere on the board
AUDIO_OUT_2: J2.19, U1.19 (AUDIO_OUT_2); also elsewhere on the board
D0: J2.1, U1.1 (D0); also elsewhere on the board
D14: J2.15, U1.15 (D14); also elsewhere on the board
ENC_A: J1.13, U1.33 (D26); also elsewhere on the board
ENC_B: J1.12, U1.32 (D25); also elsewhere on the board
ENC_CLICK: J2.14, U1.14 (D13); also elsewhere on the board
GND: J1.20, J2.20, U1.20 (AGND), U1.40 (DGND); also elsewhere on the board
I2C_SCL: J2.12, U1.12 (D11); also elsewhere on the board
I2C_SDA: J2.13, U1.13 (D12); also elsewhere on the board
LED1_B: J1.5, U1.25 (D18); also elsewhere on the board
LED1_G: J1.6, U1.26 (D19); also elsewhere on the board
LED1_R: J1.7, U1.27 (D20); also elsewhere on the board
LED2_B: J1.10, U1.30 (D23); also elsewhere on the board
LED2_G: J1.11, U1.31 (D24); also elsewhere on the board
LED2_R: J1.4, U1.24 (D17); also elsewhere on the board
POT1: J1.8, U1.28 (D21); also elsewhere on the board
POT2: J1.2, U1.22 (D15); also elsewhere on the board
SD_CK: J2.7, U1.7 (D6); also elsewhere on the board
SD_CMD: J2.6, U1.6 (D5); also elsewhere on the board
SD_D0: J2.5, U1.5 (D4); also elsewhere on the board
SD_D1: J2.4, U1.4 (D3); also elsewhere on the board
SD_D2: J2.3, U1.3 (D2); also elsewhere on the board
SD_D3: J2.2, U1.2 (D1); also elsewhere on the board
SPI_CS: J2.8, U1.8 (D7); also elsewhere on the board
SPI_MISO: J2.10, U1.10 (D9); also elsewhere on the board
SPI_MOSI: J2.11, U1.11 (D10); also elsewhere on the board
SPI_SCK: J2.9, U1.9 (D8); also elsewhere on the board
SW1: J1.14, U1.34 (D27); also elsewhere on the board
SW2: J1.15, U1.35 (D28); also elsewhere on the board
USB_D+: J1.17, U1.37 (D30); also elsewhere on the board
USB_D-: J1.16, U1.36 (D29); also elsewhere on the board

Notes on the sheet:
Mezzanine Sockets
Electrosmith Daisy Seed

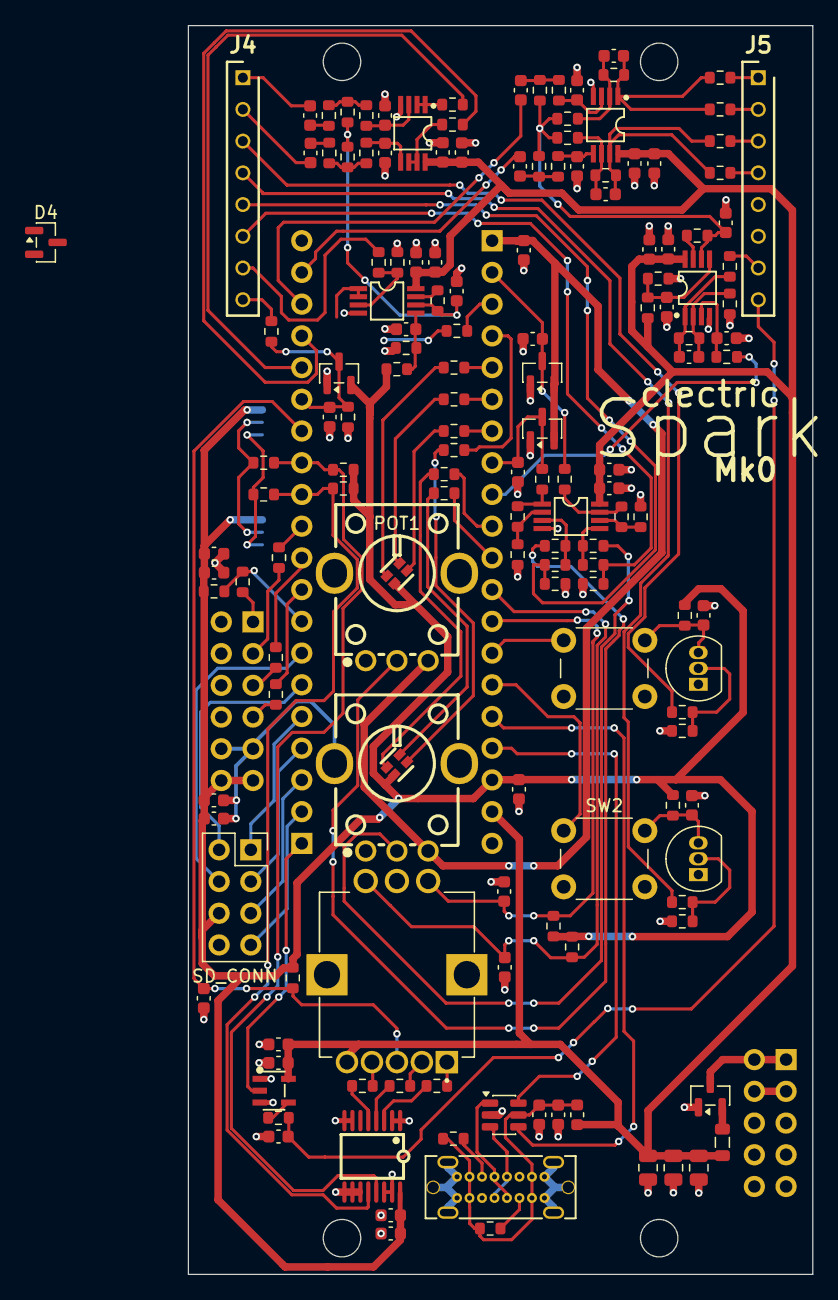
[picture p19: board Spark-AE-PCB.kicad_pcb from above]

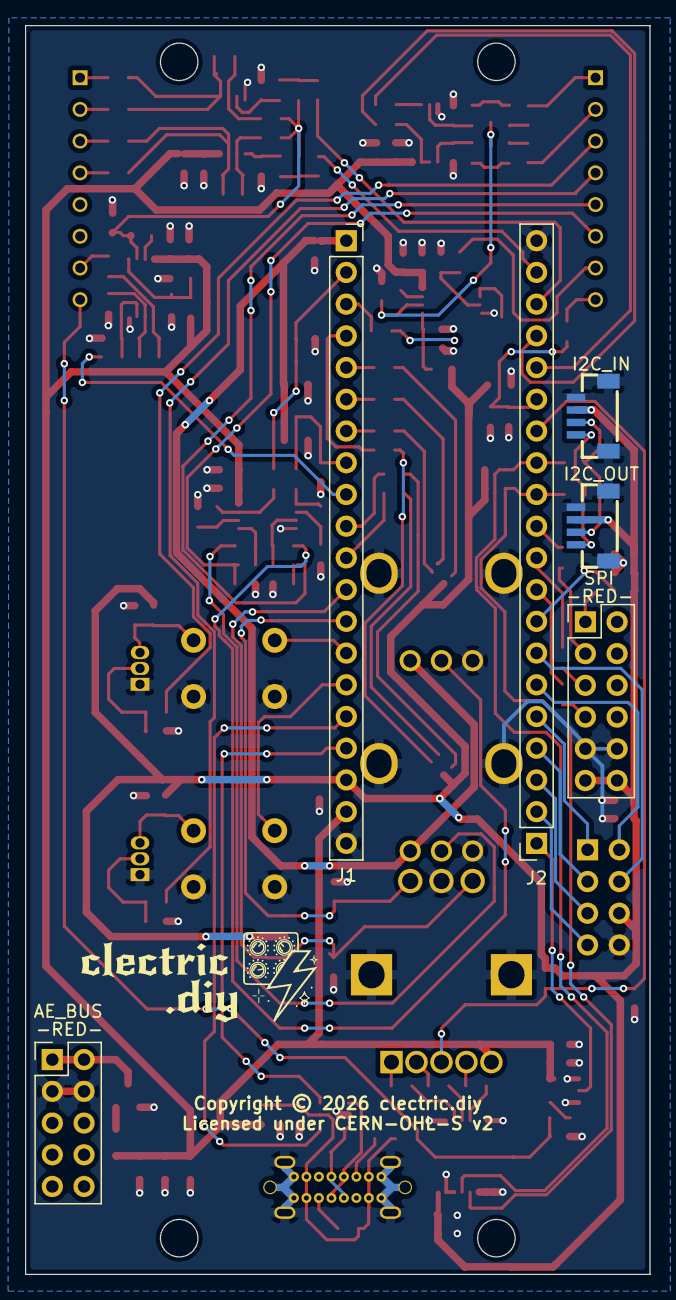
[picture p20: board Spark-AE-PCB.kicad_pcb from below]

Board: 2 copper layers, 50.0 x 100.0 mm, 161 parts (6 on the bottom side), 114 nets.
