clectric-diy/Spark-AE/(commit log)

2025-08-09 I bumped my head and the ~~flux capacitor~~ Arc was revealed.
2025-08-09 Initial commit of KiCad files
    [Spark-AE.kicad_pcb, Spark-AE.kicad_sch]
2025-08-09 Ignoring KiCad cache and backups
2025-08-09 Added Daisy Seed
    [Spark-AE.kicad_pcb, Spark-AE.kicad_sch]
2025-08-19 Added Electrosmith Source Docs
    [Seed_pinout.csv]
2025-08-22 Moving KiCad files into subdirectory
    [Spark-AE.kicad_pcb, Spark-AE.kicad_sch]
2025-09-01 Adding pdf version of module dimensions for Quickswap Case
2025-09-03 Ignoring Gerbers. Trust but verify.
2025-10-12 Found an Rotary Encoder that I think will match the AE style.
    [BOM_Spark-AE_v1.csv]
2025-10-13 Removing because part is not tested and confirmed yet.
    [BOM_Spark-AE_v1.csv]
2025-10-13 Roughing out the basic edges and control layout.
    [Spark-AE.kicad_pcb, Spark-AE.kicad_sch]
2026-01-14 removed led holes in favor of transparent pots
    [Spark-AE.kicad_pcb, Spark-AE.kicad_sch]
2026-01-14 renamed initial to panel and added other pcb projects
    [Spark-AE-Lower.kicad_pcb, Spark-AE-Lower.kicad_sch, Spark-AE-Panel.kicad_pcb, Spark-AE-Panel.kicad_sch, Spark-AE-Upper.kicad_pcb, Spark-AE-Upper.kicad_sch]
2026-01-14 filled in title blocks
    [Spark-AE-Lower.kicad_pcb, Spark-AE-Lower.kicad_sch, Spark-AE-Upper.kicad_pcb, Spark-AE-Upper.kicad_sch]
2026-01-15 bumping copyright year
    [Spark-AE-Upper.kicad_pcb, Spark-AE-Upper.kicad_sch]
2026-01-15 updated to use components from clectric-diy's library
    [Spark-AE-Upper.kicad_pcb]
2026-01-22 laid out upper board interface and connections
    [Spark-AE-Upper.kicad_pcb, Spark-AE-Upper.kicad_sch]
2026-01-22 added first render of the pcb
2026-01-23 added and connected nets for daisy seed socket
    [Spark-AE-Upper.kicad_pcb, Spark-AE-Upper.kicad_sch]
2026-01-23 updated footprints and models
    [Spark-AE-Upper.kicad_pcb, Spark-AE-Upper.kicad_sch]
2026-01-23 added nets for bus connectors
    [Spark-AE-Upper.kicad_sch]
2026-01-23 repositioned daisy seed, usb c, and micro sd
    [Spark-AE-Upper.kicad_pcb]
2026-01-23 added nets for ae modular i/o headers
    [Spark-AE-Upper.kicad_pcb, Spark-AE-Upper.kicad_sch]
2026-01-24 renamed nets to match pod and added arc connector
    [Spark-AE-Upper.kicad_pcb, Spark-AE-Upper.kicad_sch]
2026-01-24 positioned arc connector and repositioned daisy seed
    [Spark-AE-Upper.kicad_pcb]
2026-01-24 repositioned switches
    [Spark-AE-Upper.kicad_pcb]
2026-02-01 removing lower pcb and renaming to reflect change
    [Spark-AE-Lower.kicad_pcb, Spark-AE-Lower.kicad_sch, Spark-AE-PCB.kicad_pcb, Spark-AE-PCB.kicad_sch, Spark-AE-Panel.kicad_pcb, Spark-AE-Panel.kicad_sch]
2026-02-03 renamed board to reduce board count
2026-03-09 moving over progress from "Shock" (see desc)
    I attempted to create this Daisy Pod clone as an AE-1U module called the "Shock". As expected I couldn't make it work.
    I've moved my progress on the "Shock" schematic over to and replacing the work on the "Spark".
    I plan to go back to make the "Shock" a stripped down version of the "Spark" in an AE-1U format.
    [Spark-AE-PCB.kicad_pcb, Spark-AE-PCB.kicad_sch]
2026-03-10 initial committ of completely reworked schematic. thanks gemini!
    [Spark-AE-PCB-DaisySeed.kicad_sch, Spark-AE-PCB-Expansion.kicad_sch, Spark-AE-PCB-IO-1of2.kicad_sch, Spark-AE-PCB-IO-2of2.kicad_sch, Spark-AE-PCB-IO.kicad_sch, Spark-AE-PCB-Power.kicad_sch, Spark-AE-PCB-UI.kicad_sch, Spark-AE-PCB.kicad_pcb]
2026-03-12 assigned footprints & sorted ratsnest
    [Spark-AE-PCB-DaisySeed.kicad_sch, Spark-AE-PCB-Expansion.kicad_sch, Spark-AE-PCB-IO-1of2.kicad_sch, Spark-AE-PCB-IO-2of2.kicad_sch, Spark-AE-PCB-Power.kicad_sch, Spark-AE-PCB-UI.kicad_sch, Spark-AE-PCB.kicad_pcb]
2026-03-21 adding kicad_dru file with constraints for JLCPCB manufacturing and assembly
2026-03-21 ignoring KiCad backup files
2026-03-21 schematic 100% complete. pcb layout around 50% complete.
    [Spark-AE-PCB-DaisySeed.kicad_sch, Spark-AE-PCB-Expansion.kicad_sch, Spark-AE-PCB-IO-1of2.kicad_sch, Spark-AE-PCB-IO-2of2.kicad_sch, Spark-AE-PCB-Power.kicad_sch, Spark-AE-PCB-UI.kicad_sch, Spark-AE-PCB.kicad_pcb, Spark-AE-PCB.kicad_sch]
2026-03-22 continuing to plug away at pcb layout
    [Spark-AE-PCB-Expansion.kicad_sch, Spark-AE-PCB-IO-1of2.kicad_sch, Spark-AE-PCB-IO-2of2.kicad_sch, Spark-AE-PCB-Power.kicad_sch, Spark-AE-PCB-UI.kicad_sch, Spark-AE-PCB.kicad_pcb]
2026-03-23 I accdently upgraded to KiCad 10 via a `brew upgrade`. I committing before launching it just in case.
    [Spark-AE-PCB-IO-2of2.kicad_sch, Spark-AE-PCB-Power.kicad_sch, Spark-AE-PCB-UI.kicad_sch, Spark-AE-PCB.kicad_pcb]
2026-03-27 pcb layout complete. ready for final pre-fab confirmation.
    [Spark-AE-PCB-DaisySeed.kicad_sch, Spark-AE-PCB-Expansion.kicad_sch, Spark-AE-PCB-IO-1of2.kicad_sch, Spark-AE-PCB-IO-2of2.kicad_sch, Spark-AE-PCB-Power.kicad_sch, Spark-AE-PCB-UI.kicad_sch, Spark-AE-PCB.kicad_pcb, Spark-AE-PCB.kicad_sch]
2026-03-27 ignoring kicad fabrication files.
2026-03-27 Revise README for Mk0 Prototype details and edits
    Updated README to reflect changes in the Mk0 Prototype and removed a line about vertical symmetry.
2026-03-27 mk0 prototype sent for production! commit includes a couple of necessary tweaks.
    [Spark-AE-PCB-IO-2of2.kicad_sch, Spark-AE-PCB-Power.kicad_sch, Spark-AE-PCB.kicad_pcb]
2026-04-11 Restructuring directories to separate Arcs and to allow for duplicate panels
    [Spark-AE-PCB-DaisySeed.kicad_sch, Spark-AE-PCB-Expansion.kicad_sch, Spark-AE-PCB-IO-1of2.kicad_sch, Spark-AE-PCB-IO-2of2.kicad_sch, Spark-AE-PCB-IO.kicad_sch, Spark-AE-PCB-Power.kicad_sch, Spark-AE-PCB-UI.kicad_sch, Spark-AE-PCB.kicad_pcb]
2026-04-16 bumped version to Mk0.1 and corrected polarity of D4 on schematic
    [Spark-AE-PCB-DaisySeed.kicad_sch, Spark-AE-PCB-Expansion.kicad_sch, Spark-AE-PCB-IO-1of2.kicad_sch, Spark-AE-PCB-IO-2of2.kicad_sch, Spark-AE-PCB-Power.kicad_sch, Spark-AE-PCB-UI.kicad_sch, Spark-AE-PCB.kicad_pcb, Spark-AE-PCB.kicad_sch]
2026-04-26 adding Mk0.1 schematic
2026-04-26 renamed Mk0.0 prototype images
    Updated the image reference for the Mk0 Prototype render.
2026-04-26 updated to Mk0.0 for more accurate prototype versioning
2026-04-26 Fix image path for Mk0 Prototype in README
    Updated image path for Mk0 Prototype render in README.
2026-04-26 reorganizing to allow for alternate panels
    [Spark-AE-Panel-Original.kicad_pcb, Spark-AE-Panel-Original.kicad_sch]
2026-04-26 rough pass over original mk0.1 panel. needs confirmation.
    [Spark-AE-Panel-Original.kicad_pcb, Spark-AE-Panel-Original.kicad_sch]
2026-04-26 made lightburn version for fast prototyping
    [Spark-AE-Panel-Original-Edge_Cuts.dxf, Spark-AE-Panel-Original-F_Silkscreen.dxf]
2026-04-29 removed front flash port. sorry.
    [Spark-AE-Panel-Original.kicad_pcb]
