clectric-diy/Spark-AE/(notices)

Notices in the files:
KiCad/Spark-AE-PCB/Spark-AE-PCB-Expansion.kicad_sch:
Copyright © 2026 clectric.diy Licensed under CERN-OHL-S v2
